muhammad0bi/Technion_044167_E.E._project_A_IOT-Barcode_cheker/Layout/PC0101122A_TOP.png

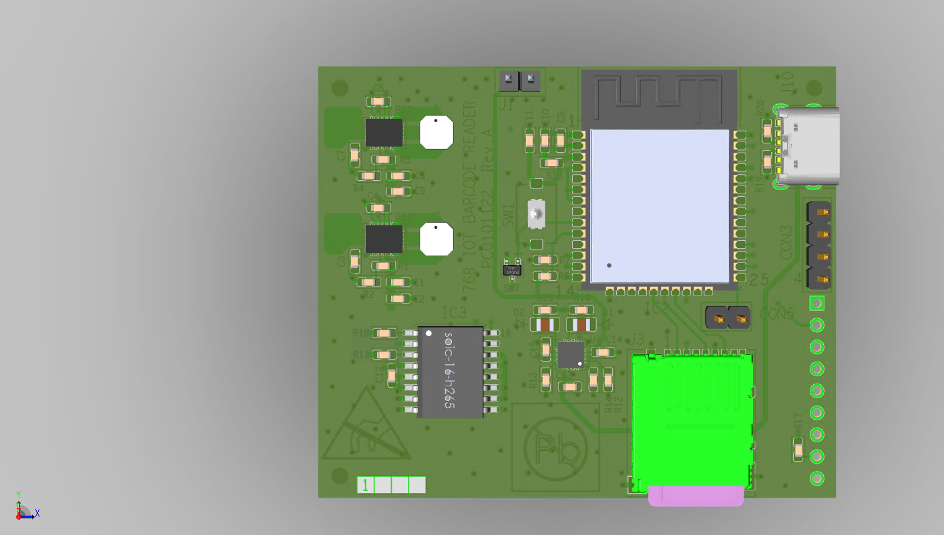
Layout/PC0101122A_TOP.png
