muhammad0bi/Technion_044167_E.E._project_A_IOT-Barcode_cheker/Poster/poster.pptx

IOT-Barcode checker
Omar Sharafi & Muhammad Biadsy
Supervised by: Mony Orbach

After all, with the project expectations, almost all the project requirement were achieved:
- Create a user-friendly device that Compare between barcodes and give us a clear result.
- Provide a log with all the scanning result via Wi-Fi with a real-time stamp.
- Mobile, compact and Re-chargeable.
- Easy to understand code.

The Andrew & Erna Viterbi Faculty of
Electrical Engineering

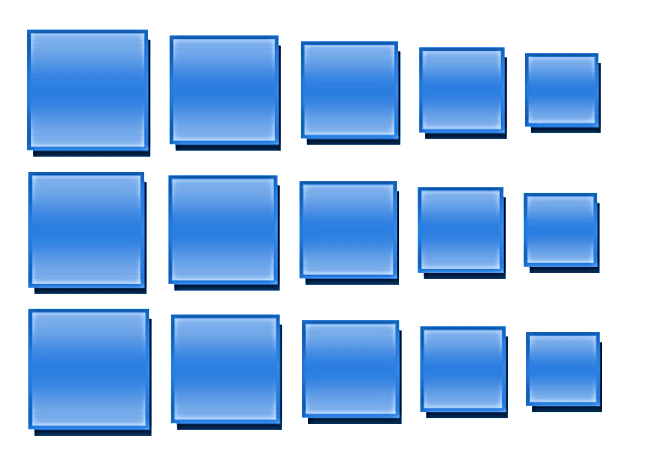
[picture p3: figure]

Electronics
Computers
Communications

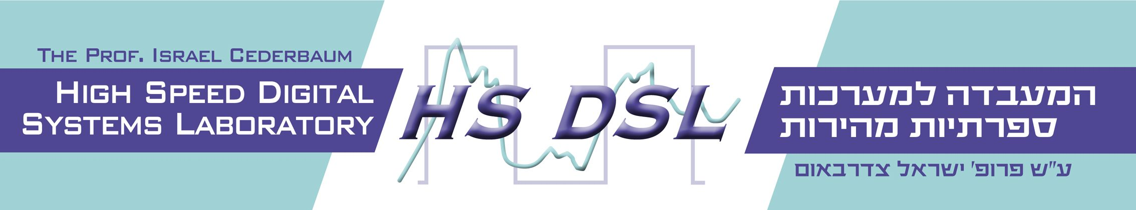
[picture p4: figure]
Technion
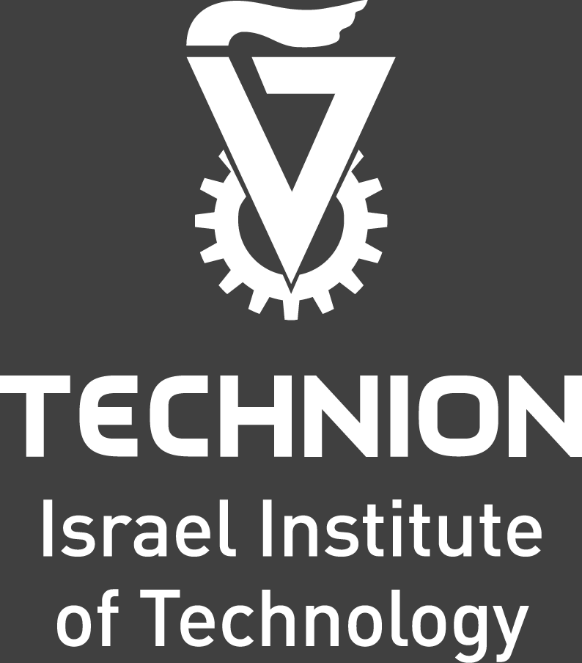
[picture p5: figure]

Project goals

- This project, in collaboration with Bnai Zion Medical Center, addresses the mismanagement of patient samples in hospital laboratories.
- Patient samples are barcoded, but manual handling of multiple samples can cause mix-ups. Reliable verification is needed to ensure accuracy at every stage.
- To avoid this problem, we want to develop A Compact And Portable Device that :
  - Compare between barcodes and give us a clear result.
  - Provide a log with all the scanning results.
  - Communicatee via Wi-Fi with a computer.
  - Mobile, compact and Re-chargeable.

Block Diagram

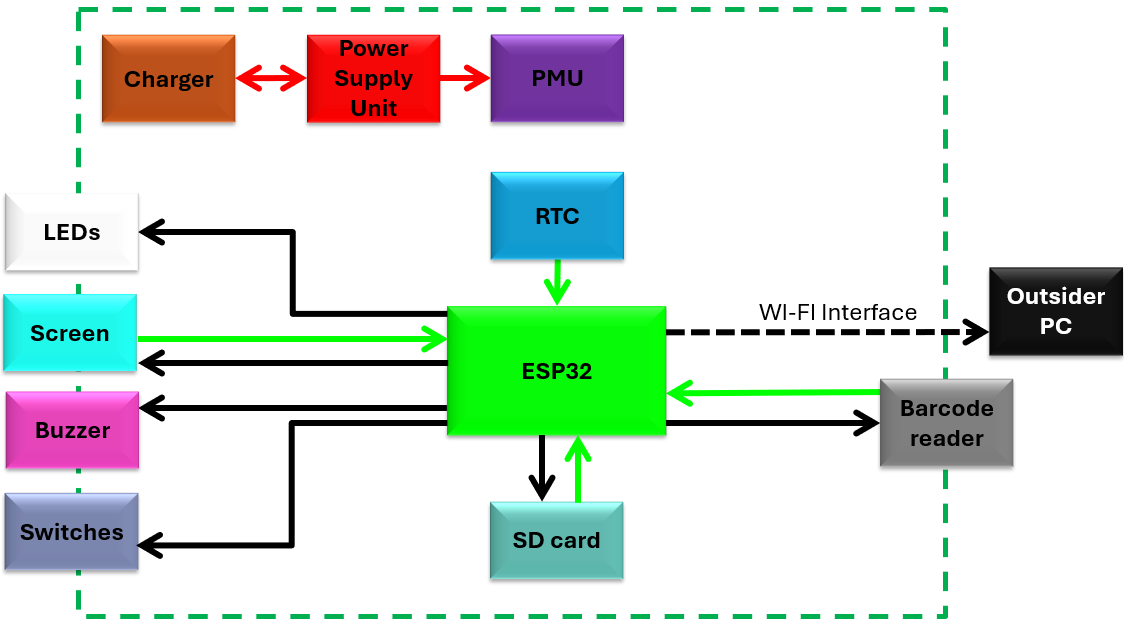
[picture p6: figure]
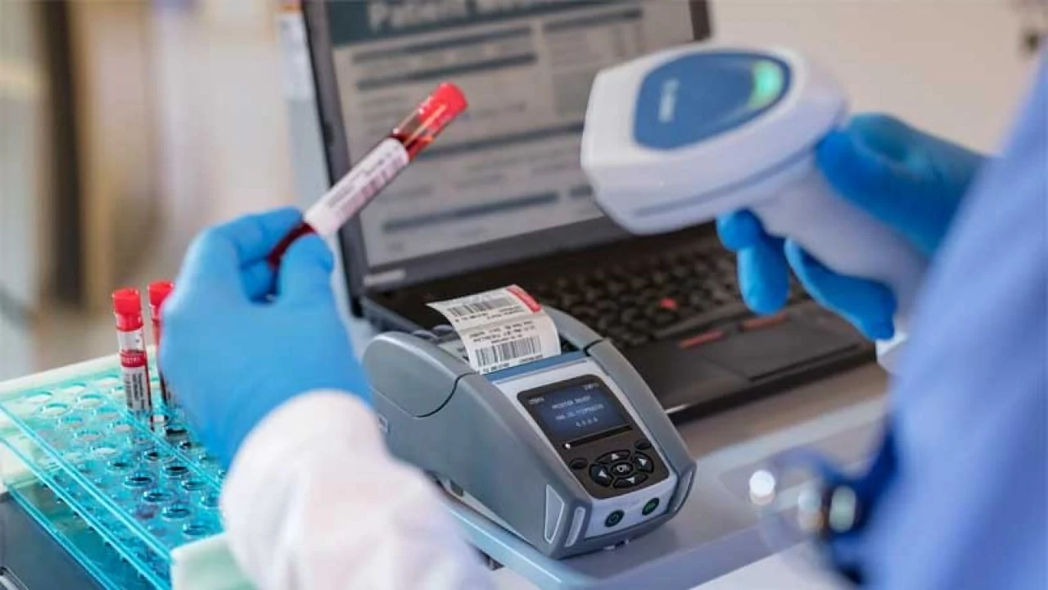
[picture p7: figure]

Flow Chart

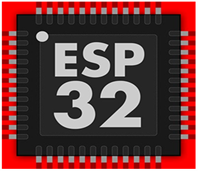
[picture p8: figure]
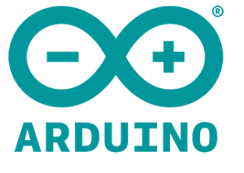
[picture p9: figure]

Device Screen & Wi-fi page

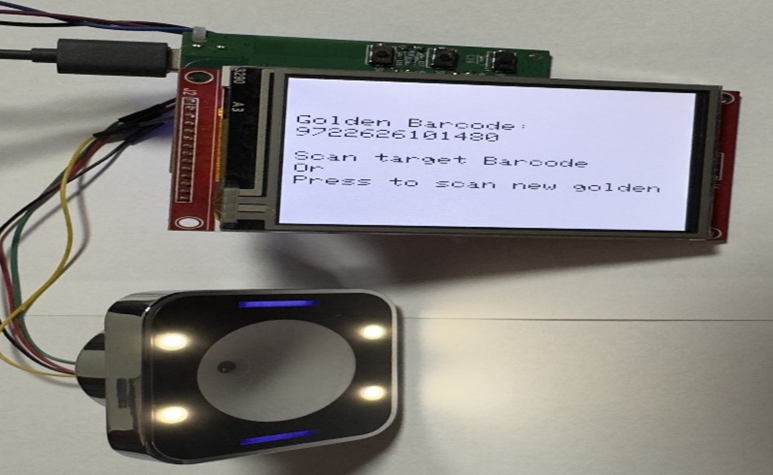
[picture p10: figure]
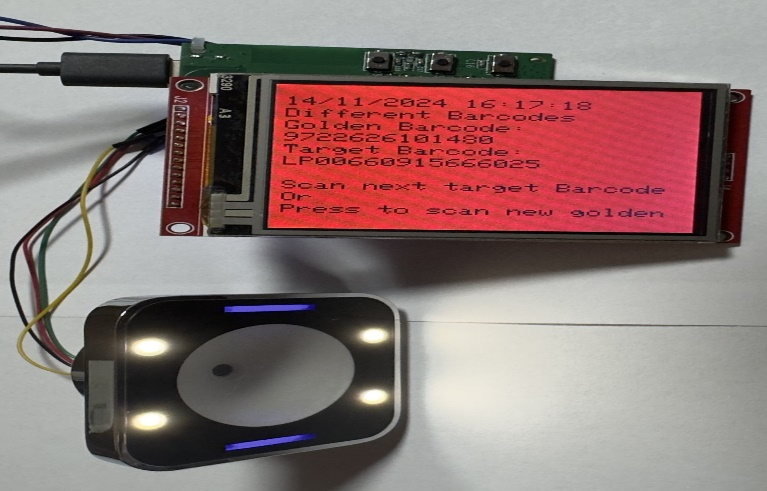
[picture p11: figure]

Communication Map

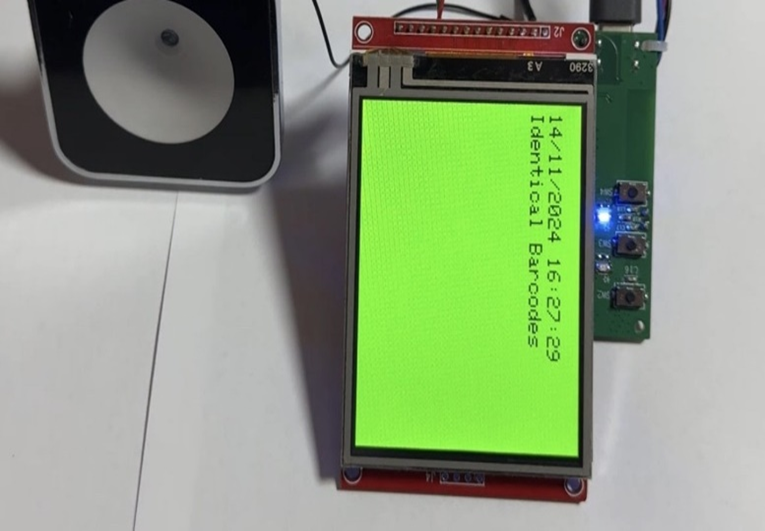
[picture p12: figure]
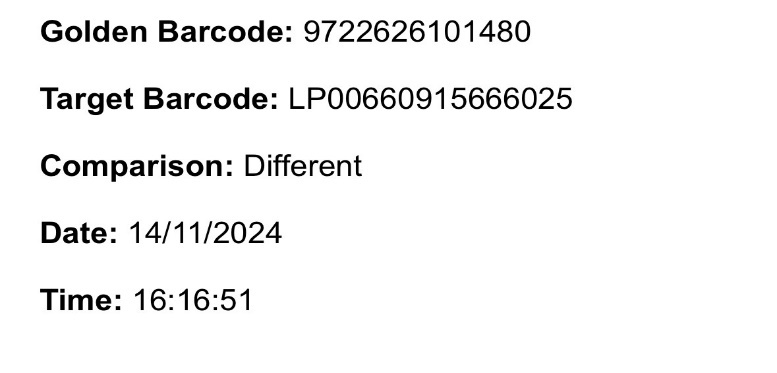
[picture p13: figure]
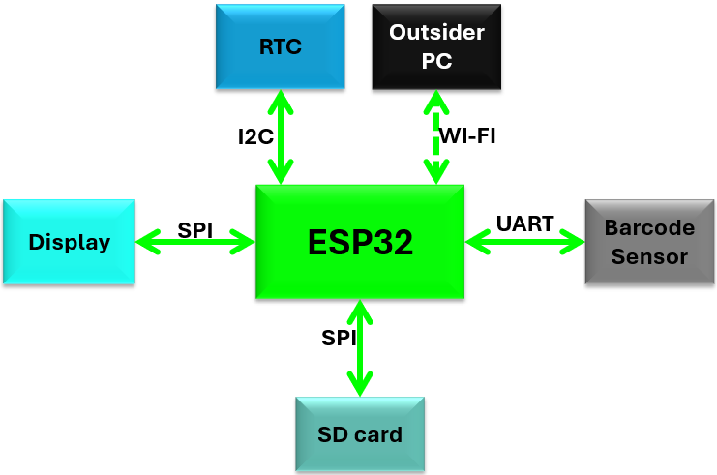
[picture p14: figure]

Results

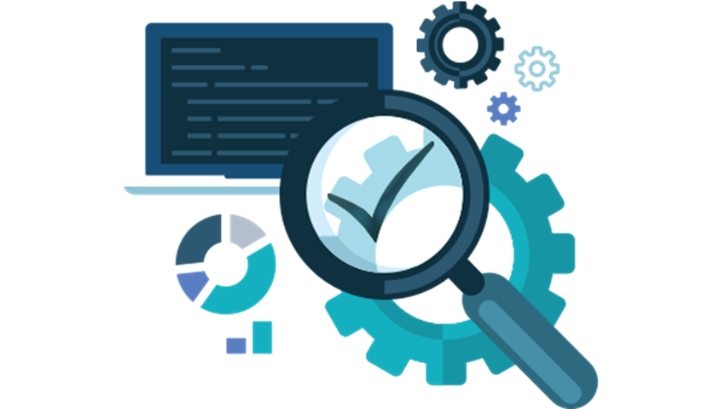
[picture p15: figure]
