muhammad0bi/Technion_044167_E.E._project_A_IOT-Barcode_cheker/Web/short descrption of the project.docx

In collaboration with Bnai Zion Medical Center, this project aims to develop a low-cost barcode checker device to prevent mismanagement of patient samples through accurate labeling with unique barcodes.
