muhammad0bi/Technion_044167_E.E._project_A_IOT-Barcode_cheker/Presntations/Midterm presentation IOT Barcode checker 7681.pptx

## MIDTERM presentation Barcode CHECKER 7681

By: Omar Sharafy, Muhammad Biadsy
Instructor: Mony Orbach
Lab: HSDSL
Spring Semester 2024

## BACKGOUND & Motivation

In Hospitals, Samples are collected from patients and labeled with unique barcode stickers.
- Visual Checking: In the lab, samples are checked visually against patient barcodes in the system.
- Potential Issues: High number of samples can cause confusion and mix-ups, resulting in issuing wrong meds and treatments.
- Difficulty in Comparison: Visual comparison of barcodes is challenging for lab personnel (Or any human for that matter).

## Goals

- Development of an easy to carry and simple tool that solves the problem of confusion in the hospital laboratory .
The tool should :
- Compare between barcodes and give us a clear result.
- Provide a log with all the scanning results.
- Mobile, compact and Re-chargeable.
- communicatee via Wi-Fi with a computer.

## Components & work development

Components :
- Barcode reader (Including built in buzzer).
- Esp32.
- Screen - SPI TFT LCD.
- Realtime clk.
- Charger – USB Type-C.
- Sd card.
- LEDs.

Work development :
Arduino developing environment.

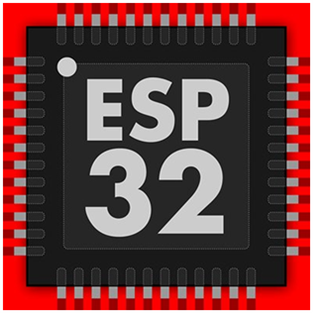
[picture p51: figure]
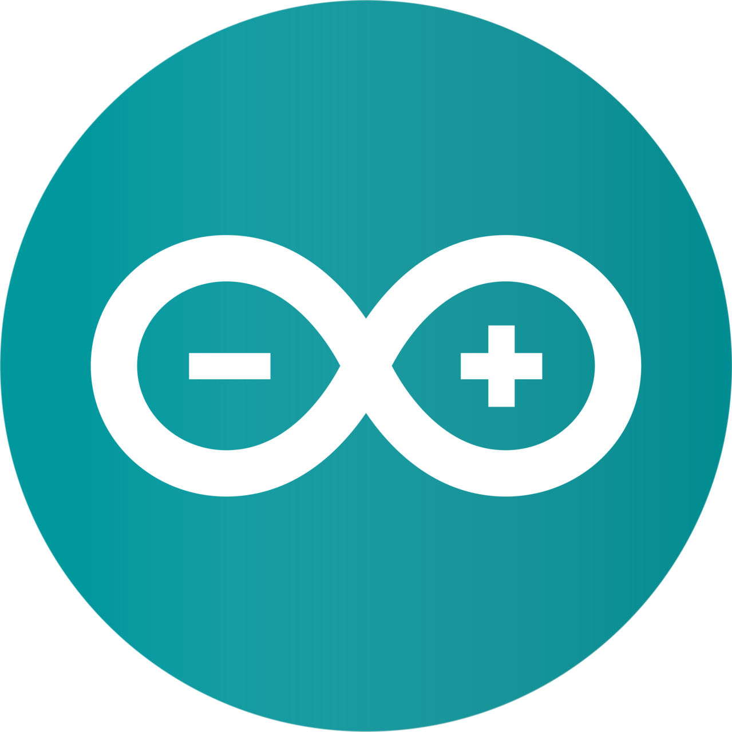
[picture p52: figure]

Notes: Barcode Dimension 2.6*5.6*5.6cm
Screen 4.2 * 3.9 inches

## TOP VIEW Block diagram

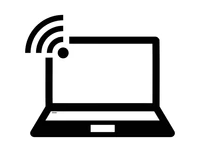
[picture p53: figure]

Outsider PC

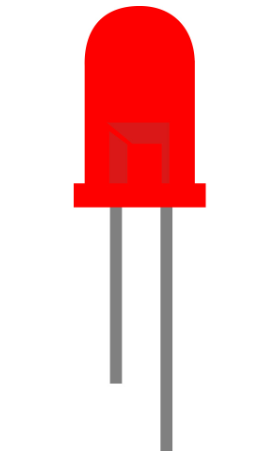
[picture p54: figure]
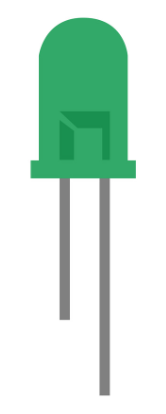
[picture p55: figure]

WI-FI
Interface

DEVICE

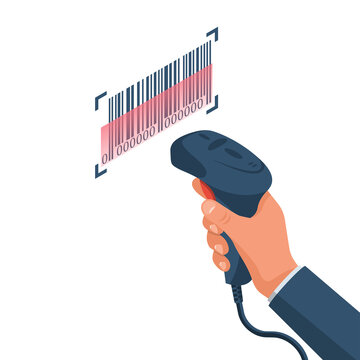
[picture p56: figure]

Target Barcode

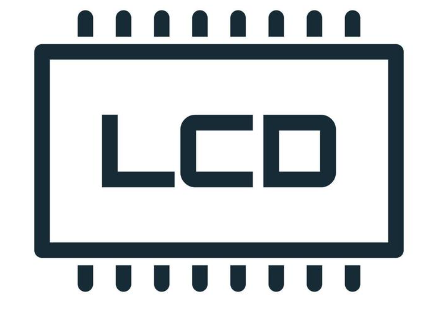
[picture p57: figure]

User

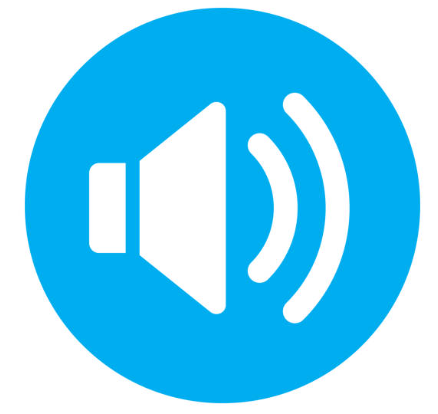
[picture p58: figure]
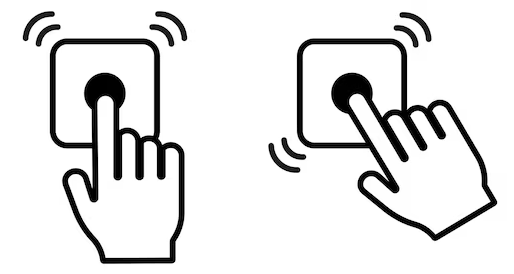
[picture p59: figure]

## Mod of work Diagram

Show the result via sound + screen & LED’s, and save the result

start

Scan the “Golden barcode”

Scan the target barcode

- After each comparison, we will log both the Golden and target barcodes, along with the results, time and date of scanning.
- When the device’s memory is full, the user can decide if he wants to override some results or delete all and start a new log.
- The log record can be accessed via WI-FI.

## Block diagram

Charger

Power Supply Unit

PMU

LEDs

RTC

ESP32

Screen

WI-FI Interface

Outsider PC

Barcode reader

Buzzer

Switches

SD card

## Power MNAGMENT UNIT

Input 5V

DC/DC Converter

DC/DC Converter

For Barcode reader

Output 5V

Output 3.3V

For ESP32 & other components

## Communication Diagram

RTC

I2C

Outsider PC

WI-FI

Display

SPI

ESP32

SPI

SD card

UART

Barcode Sensor

## ESP32

- Includes many drivers that make programming easier.
- Advantages over Arduino nano: speed and memory
- 2 cores.

| ESP32 | Arduino nano
Clock rate | 80 MHz | 16 MHz
Memory size | 520 KB SRAM 4 MB flash memory | 2 KB SRAM 32 KB flash

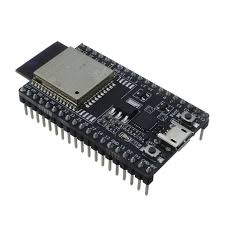
[picture p60: figure]
ESP32-DEVKITC-32D Espressif Systems | RF/IF ו- RFID | DigiKey

## Barcode reader

- 2D Barcode scanner.
- Built in buzzer that we can adapt it to our project.
- Supports Arduino development Environment.

Notes: 125 mA = I
Built in buzzer
Built in led

## Display

- 3.2 inch.
- 240X320 pixels.
- Supports Arduino development Environment.
- Can be powered with 3.3V.

## Arduino developing environment

- Supports the ESP32.
- Rich collection of libraries for various sensors and communication protocols.
- Easy to use and quickly start coding.
- Supports wide range of applications.

## Until now

- Define objectives.
- E.E Scheme.
- PCB design – in production process.
- Case design in process.

## Layout - TOP

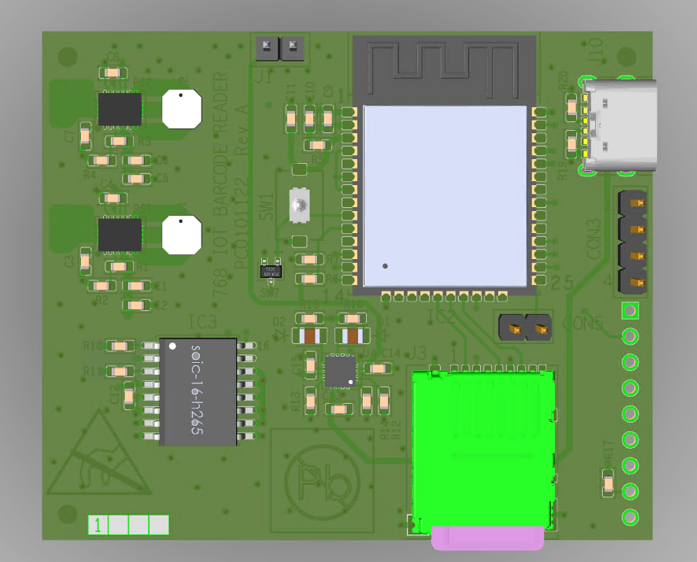
[picture p61: figure]
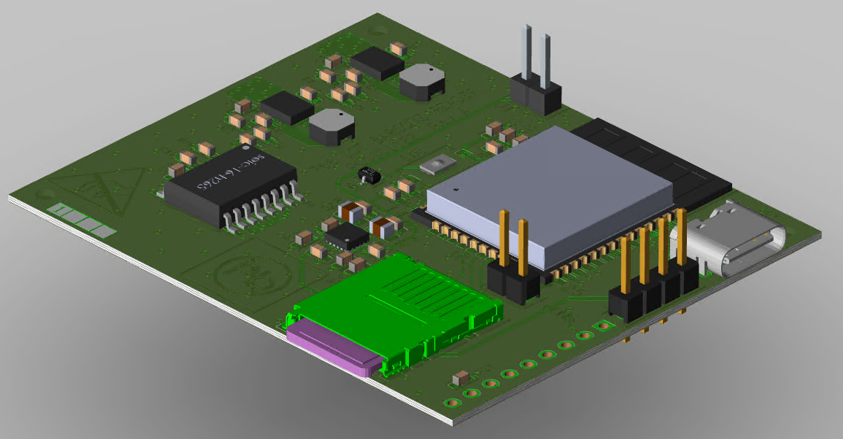
[picture p62: figure]

## Layout - BOTTOM

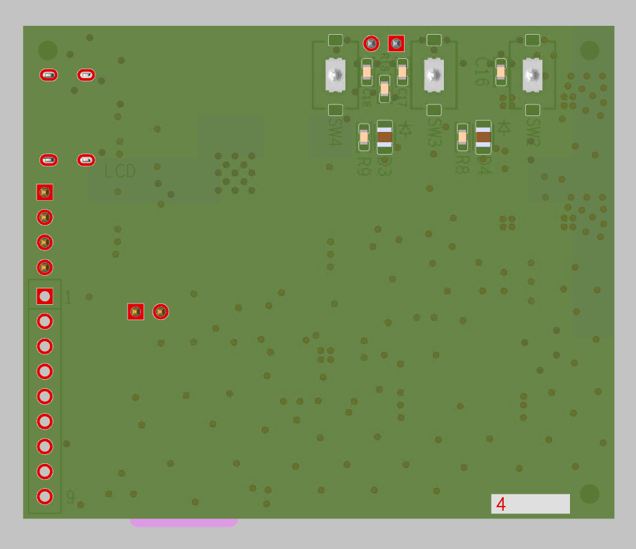
[picture p63: figure]
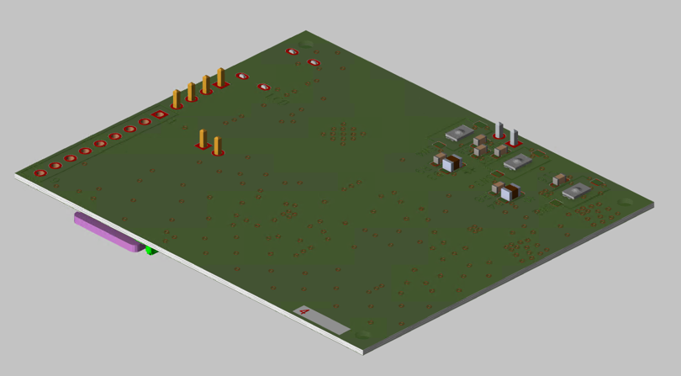
[picture p64: figure]

## Gant diagram

| 18Aug24 | 25Aug24 | 1Sep24 | 22Sep24 | 29Sep24 | 5Oct24 | 19Oct24 |10Nov24

layout

Today

Exams

Designing a case via 3D Printer

Software development

Debug

Hardware bring-up

Integration

Final presentation
