muhammad0bi/Technion_044167_E.E._project_A_IOT-Barcode_cheker/Layout/PCB_Layout.pptx

HOME Unit

barcode con

Dc2d 3v

Dc2d 5v

Esp32

Screen con
9 pins not 4

RTC

Switch

Switch

Switch

+

2cm

Battary con

LED

LED

USB

## Slide 2

FIELD Unit

Sd card
