muhammad0bi/Technion_044167_E.E._project_A_IOT-Barcode_cheker/Project_Arduino_code/Readme.txt

This file contains the software aspect of our project.

1) The Project_Arduino_code file includes the final code that was uploaded to the ESP32.
2) The Bring_up_components folder contains a collection of files,
each representing a small test program used to verify and initialize individual components of our project.
Each file is named after the specific component it was designed to test and bring up.
