muhammad0bi/Technion_044167_E.E._project_A_IOT-Barcode_cheker/Electrical Schematic/Original_re-wired/DC_TO_DC_3V.pdf

## Notes:

1. The value of the inductor is from TPS63020DSJT,

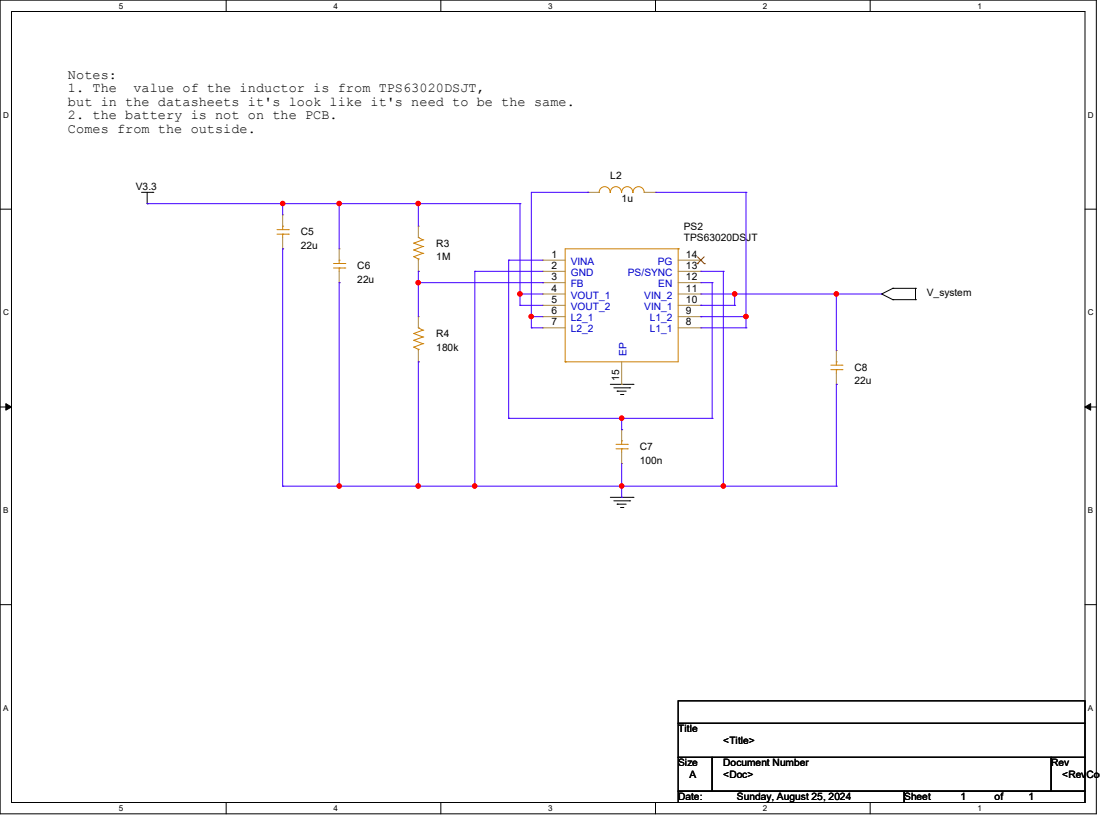
[picture p70: page 1]
V_system; Title; Size; Document Number; Rev; Date:; Sheet; <Doc>; <RevCode>; <Title>; Sunday, August 25, 2024; PS2 TPS63020DSJT; VINA 1 GND 2 FB 3 VOUT_1 4 VOUT_2 5 L2_1 6; PS/SYNC; VIN_2; VIN_1

but in the datasheets it's look like it's need to be the same.
2. the battery is not on the PCB.
Comes from the outside.
