muhammad0bi/Technion_044167_E.E._project_A_IOT-Barcode_cheker/Electrical Schematic/Original_re-wired/DC_TO_DC_BOOST_5V.pdf

## Notes:

1. The value of the inductor is from TPS63020DSJT,

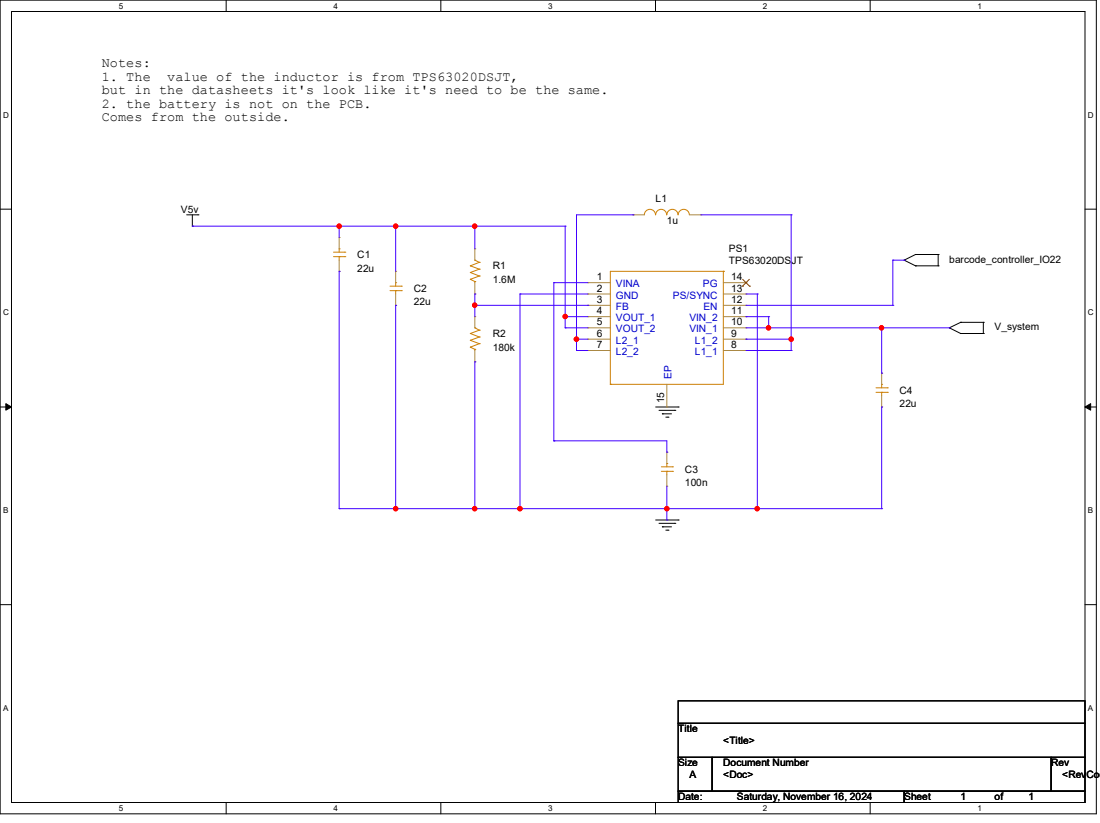
[picture p71: page 1]
barcode_controller_IO22; V_system; Title; Size; Document Number; Rev; Date:; Sheet; <Doc>; <RevCode>; <Title>; Saturday, November 16, 2024; PS1 TPS63020DSJT; VINA 1 GND 2 FB 3 VOUT_1 4 VOUT_2 5 L2_1 6; PS/SYNC; VIN_2; VIN_1

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
