muhammad0bi/Technion_044167_E.E._project_A_IOT-Barcode_cheker/Electrical Schematic/Original_re-wired/PMU.pdf

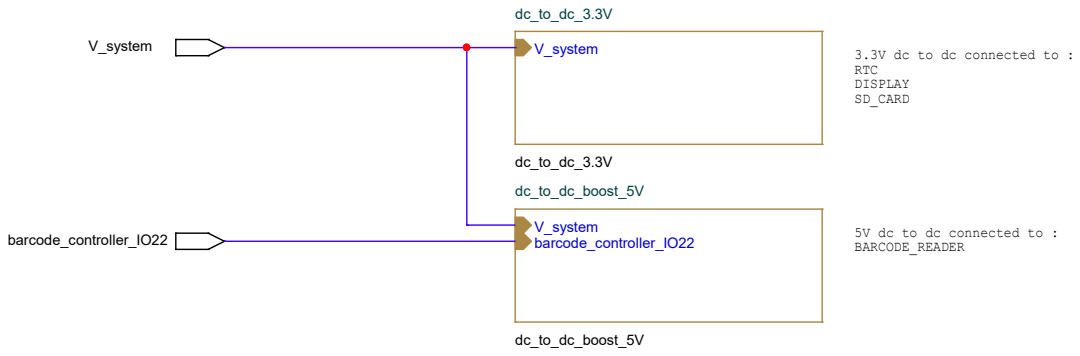
[picture p73: page 1]
BARCODE_READER barcode_controller_IO22; V_system; Title; Size; Document Number; Rev; Date:; Sheet; <Doc>; <RevCode>; <Title>; Saturday, November 16, 2024; dc_to_dc_boost_5V; barcode_controller_IO22

3.3V dc to dc connected to :
RTC
DISPLAY
SD_CARD

5V dc to dc connected to :
