muhammad0bi/Technion_044167_E.E._project_A_IOT-Barcode_cheker/Electrical Schematic/Original_re-wired/RTC.pdf

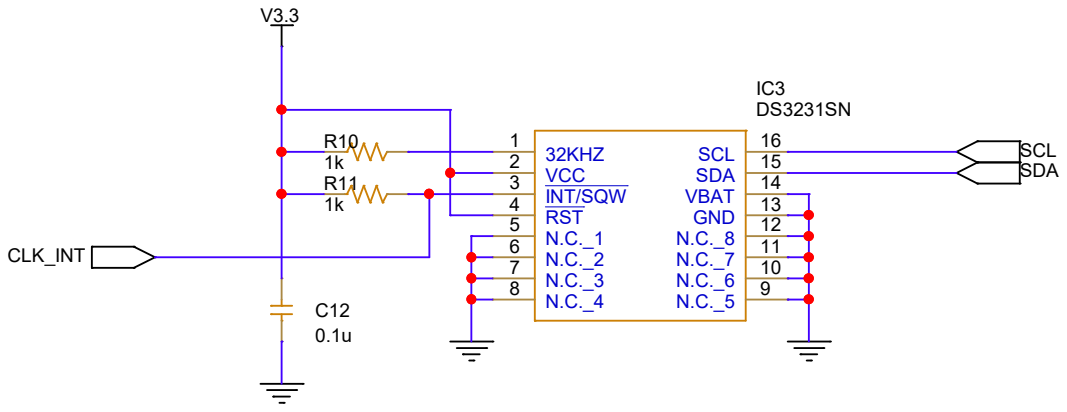
[picture p74: page 1]
SCL SDA; CLK_INT; Title; Size; Document Number; Rev; Date:; Sheet; <Doc>; <RevCode>; <Title>; Sunday, August 25, 2024; 32KHZ 1 VCC 2 INT/SQW 3 RST 4 N.C._1 5 N.C._2 6 N.C._3 7 N.C._4 8; SCL; SDA; VBAT; GND
