muhammad0bi/Technion_044167_E.E._project_A_IOT-Barcode_cheker/Electrical Schematic/Original_re-wired/SD_SLOT.pdf

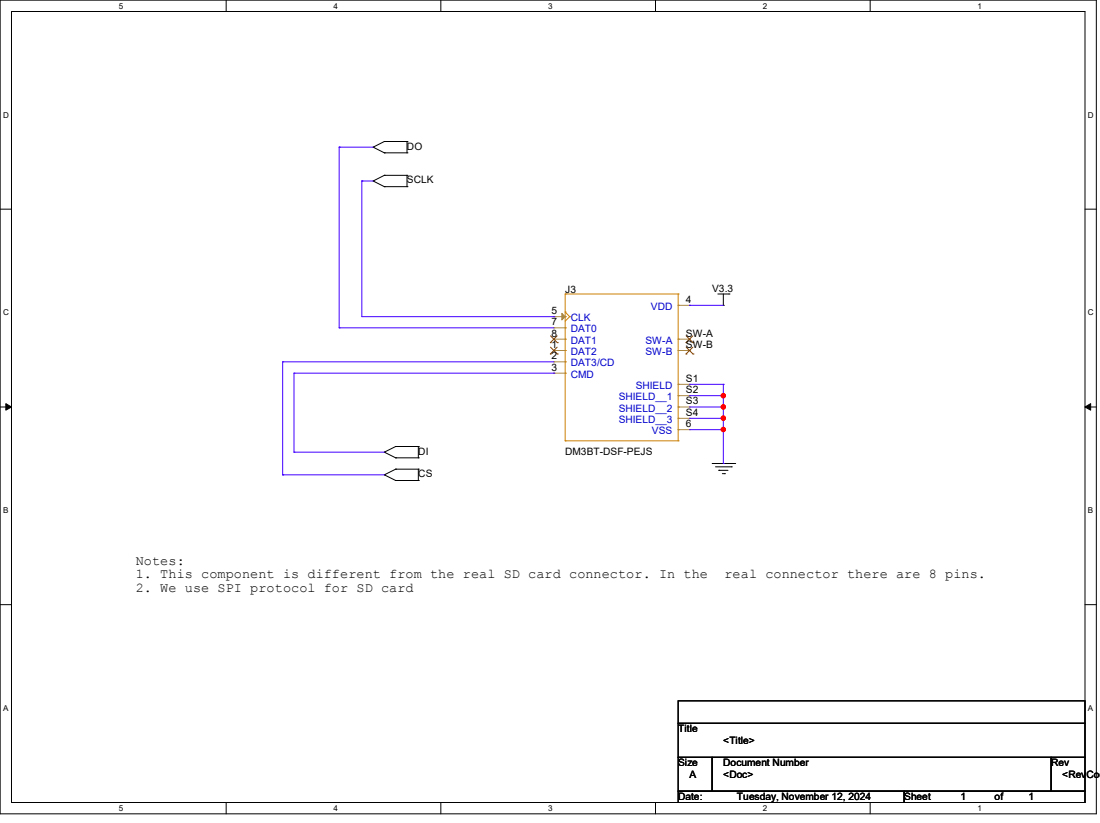
[picture p75: page 1]
SCLK; Title; Size; Document Number; Rev; Date:; Sheet; <Doc>; <RevCode>; <Title>; Tuesday, November 12, 2024; DM3BT-DSF-PEJS; SHIELD; SHIELD__2; S3 SHIELD__1; SHIELD__3; DAT2 1 DAT3/CD 2 CMD 3; VDD; CLK 5; VSS; DAT0 7; DAT1 8

Notes:
1. This component is different from the real SD card connector. In the real connector there are 8 pins.
2. We use SPI protocol for SD card
