muhammad0bi/Technion_044167_E.E._project_A_IOT-Barcode_cheker/Electrical Schematic/Original_re-wired/SWITCHS.pdf

## Notes: 1. the inputs going out and connecting to

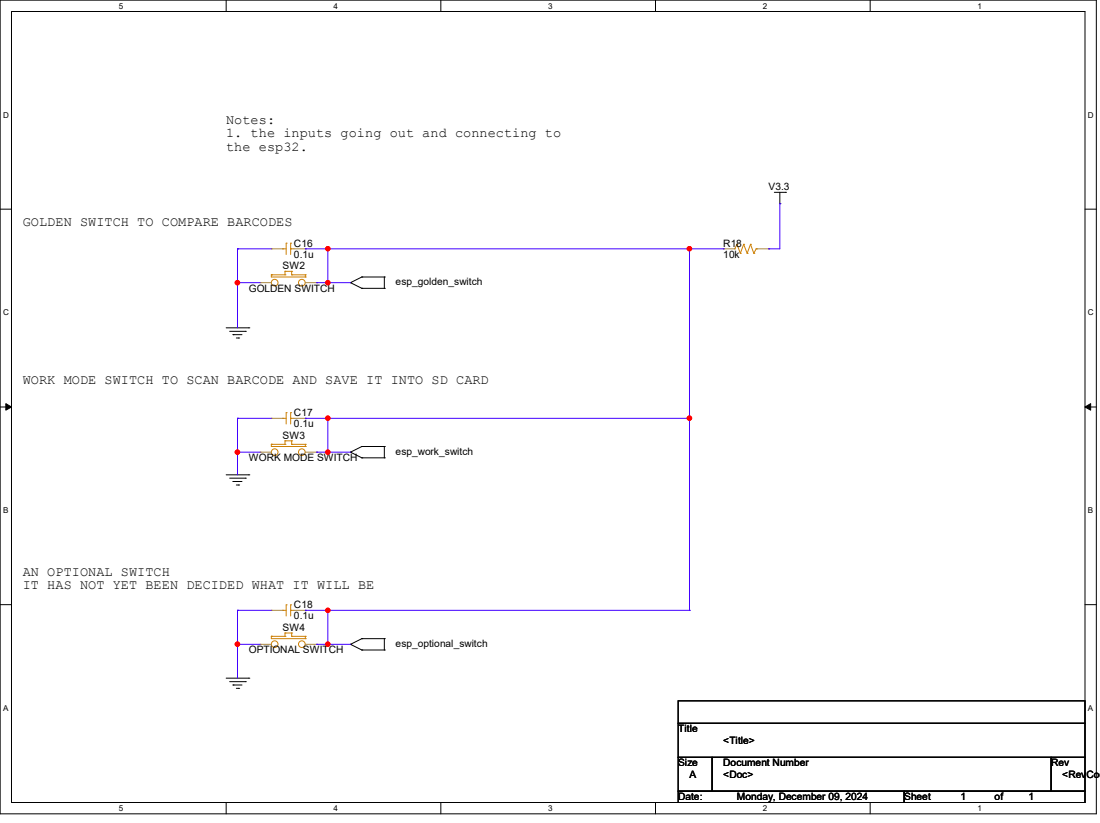
[picture p76: page 1]
the esp32.; esp_golden_switch; esp_work_switch; esp_optional_switch; Title; Size; Document Number; Rev; Date:; Sheet; <Doc>; <RevCode>; <Title>; Monday, December 09, 2024; GOLDEN SWITCH; OPTIONAL SWITCH

GOLDEN SWITCH TO COMPARE BARCODES

WORK MODE SWITCH TO SCAN BARCODE AND SAVE IT INTO SD CARD

WORK MODE SWITCH

AN OPTIONAL SWITCH
IT HAS NOT YET BEEN DECIDED WHAT IT WILL BE
