muhammad0bi/Technion_044167_E.E._project_A_IOT-Barcode_cheker/Electrical Schematic/Original_re-wired/Top.pdf

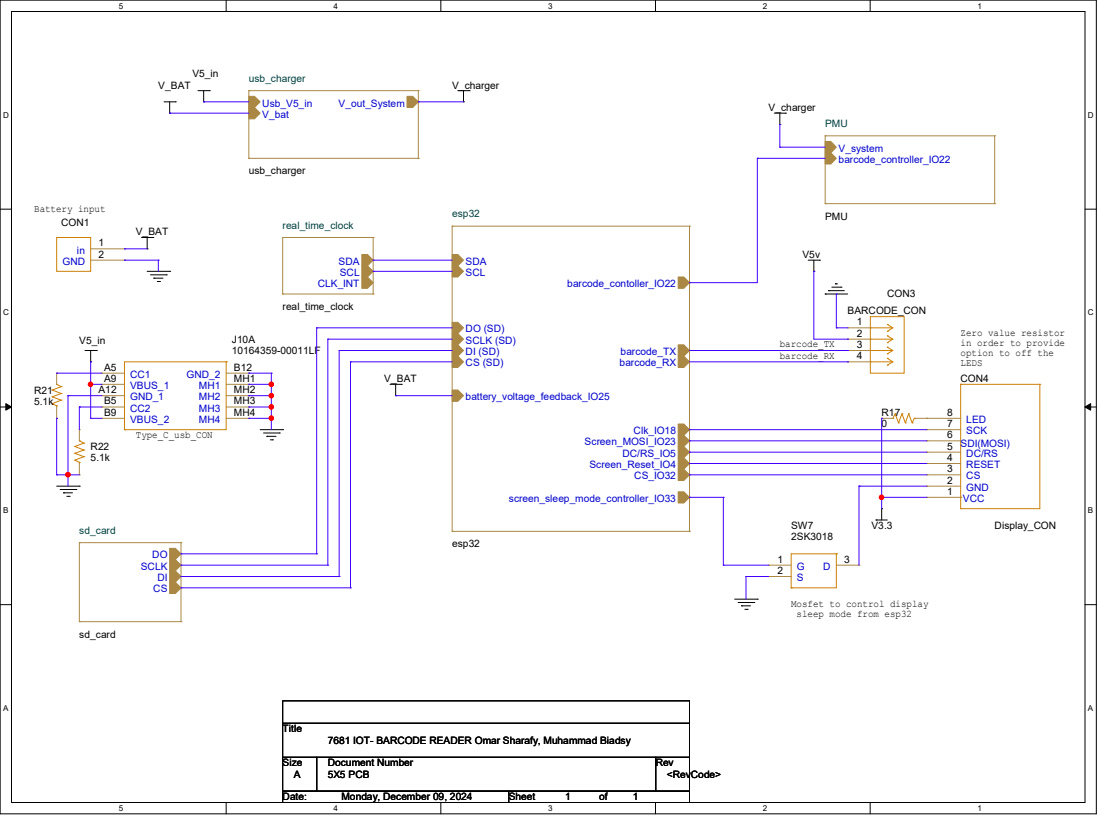
[picture p77: page 1]
barcode_RX; barcode_TX; Battery input; Type_C_usb_CON; V_BAT; V_charger; Title; Size; Document Number; Rev; Date:; Sheet; 5X5 PCB; <RevCode>; Monday, December 09, 2024; esp32; battery_voltage_feedback_IO25; SCLK (SD) DI (SD); screen_sleep_mode_controller_IO33; barcode_contoller_IO22; barcode_TX barcode_RX; Screen_Reset_IO4; Screen_MOSI_IO23; Clk_IO18; SDA SCL; PMU; barcode_controller_IO22; V_system; usb_charger; Usb_V5_in; V_out_System; V_bat; real_time_clock; SCL; SDA; CLK_INT; sd_card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

Zero value resistor
in order to provide
option to off the
LEDS
CON4

VBUS_2 B9

Mosfet to control display
sleep mode from esp32

7681 IOT- BARCODE READER Omar Sharafy, Muhammad Biadsy
