muhammad0bi/Technion_044167_E.E._project_A_IOT-Barcode_cheker/Electrical Schematic/Original_re-wired/USB_TYPE_C_CHARGER.pdf

## CHARGER THAT STOPS CHARGING AUTOMATICALLY WHEN THE BATRY IS FULL

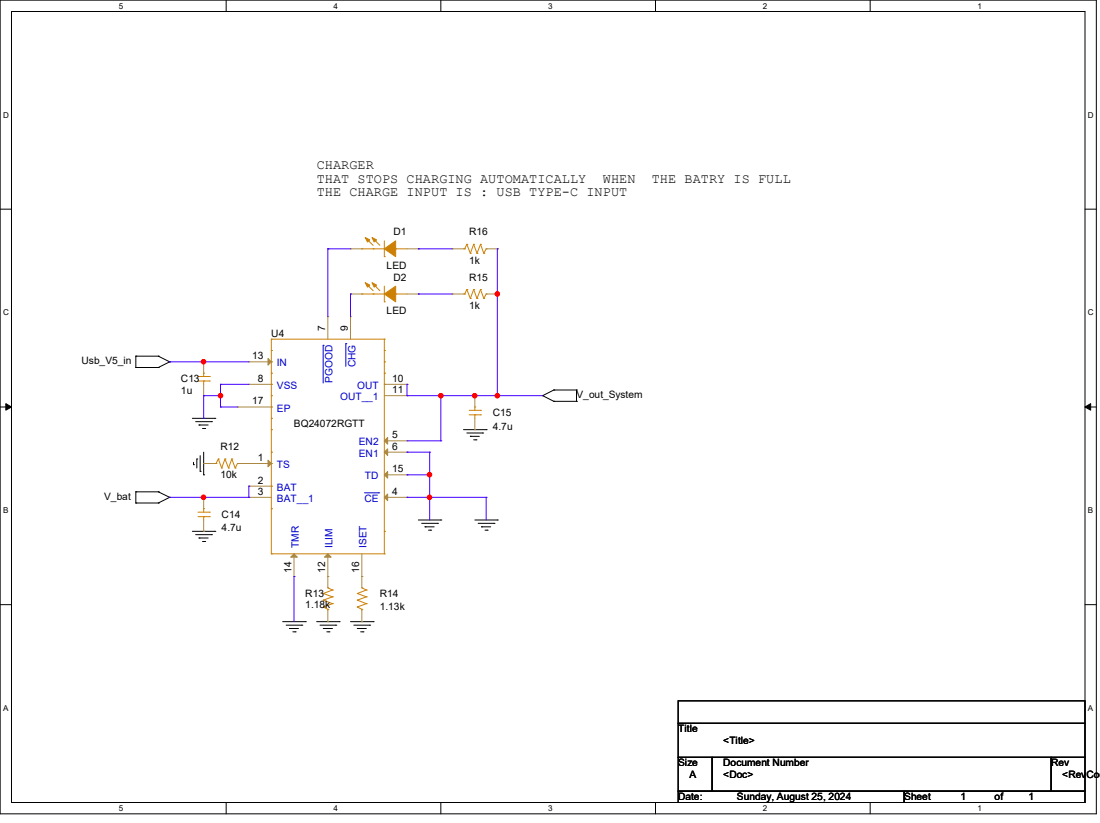
[picture p78: page 1]

THE CHARGE INPUT IS : USB TYPE-C INPUT
