muhammad0bi/Technion_044167_E.E._project_A_IOT-Barcode_cheker/Layout/PC0101122A__PC0101122A_BOARD.pdf

# Technion - Department of Electrical Engineering C3 C7 1

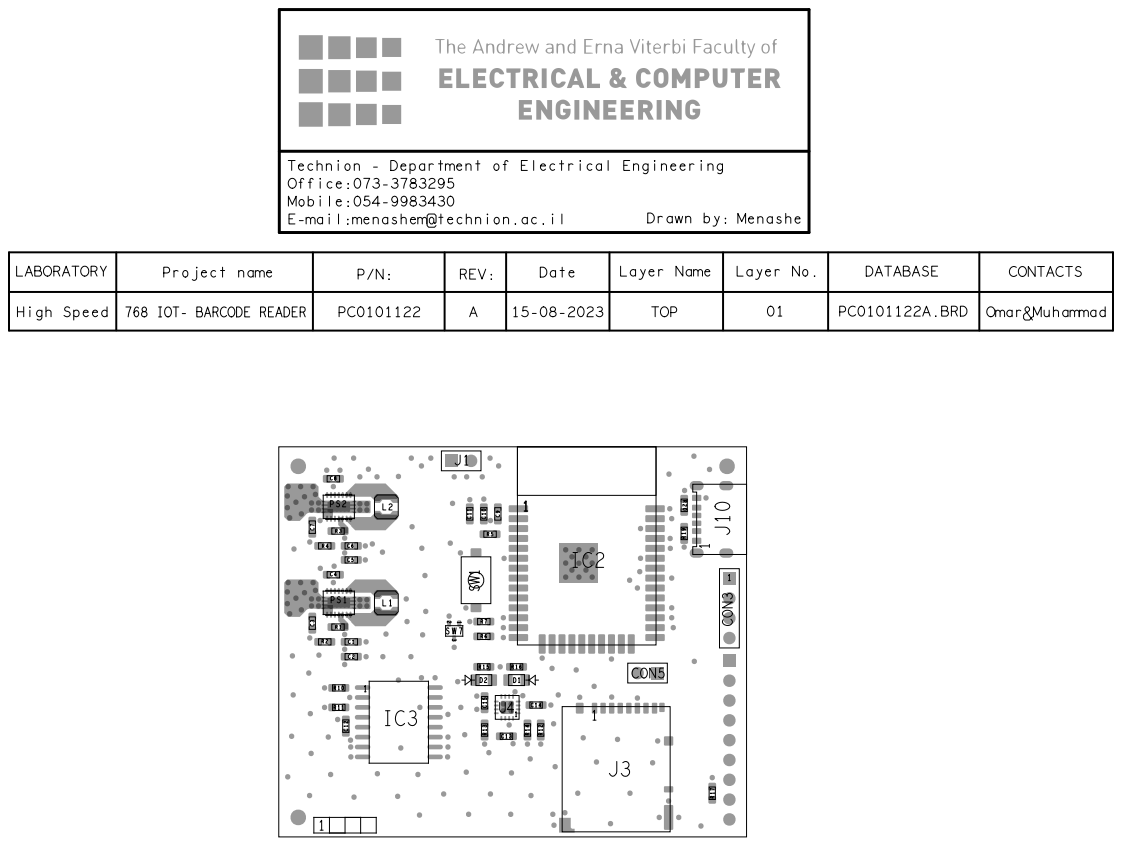
[picture p79: page 1]

Office:073-3783295
Mobile:054-9983430
E-mail:menashem@technion.ac.il

LABORATORY | Project name | Date | Layer Name | Layer No. | DATABASE | CONTACTS

High Speed | 768 IOT- BARCODE READER | 15-08-2023 | TOP | 01 | PC0101122A.BRD | Omar&Muhammad

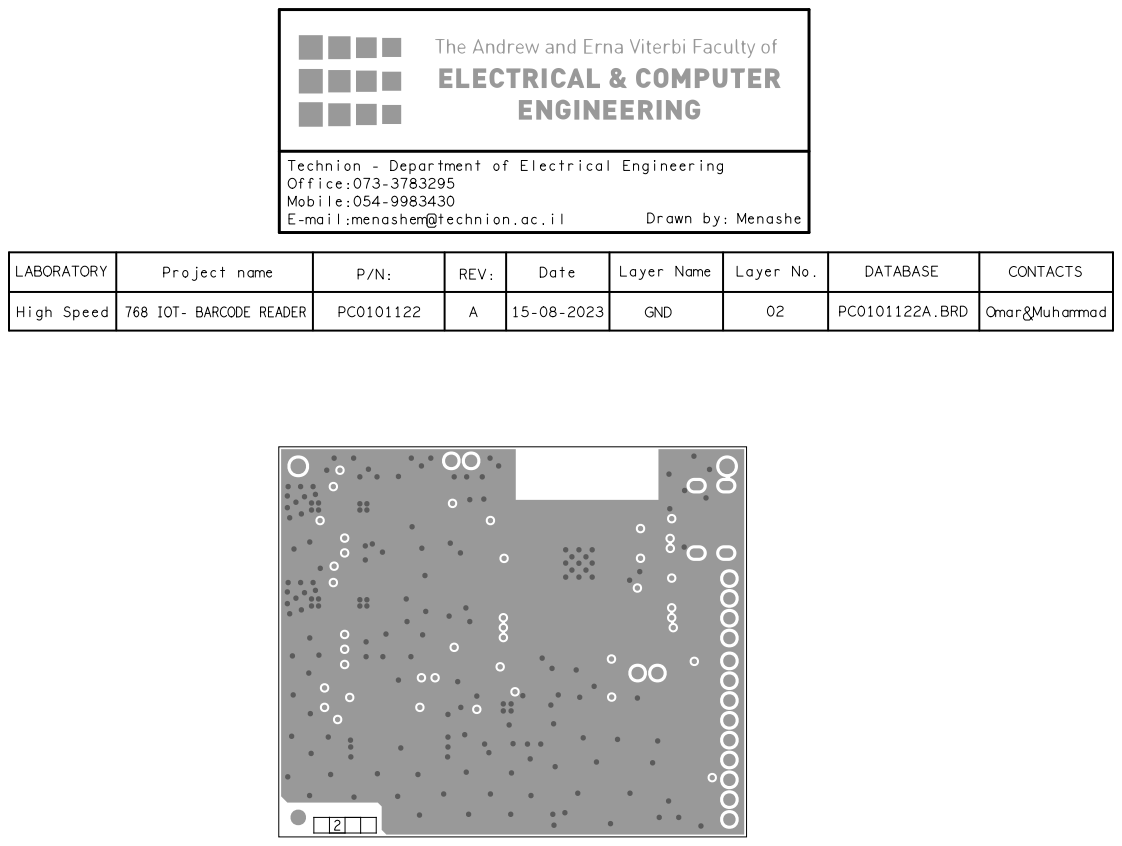
[picture p80: page 2]
Drawn by:; Menashe

Technion - Department of Electrical Engineering
Office:073-3783295
Mobile:054-9983430
E-mail:menashem@technion.ac.il

LABORATORY | Project name | P/N: | REV: | Date | Layer Name | Layer No. | DATABASE | CONTACTS

High Speed | 768 IOT- BARCODE READER | PC0101122 | A | 15-08-2023 | GND | 02 | PC0101122A.BRD | Omar&Muhammad

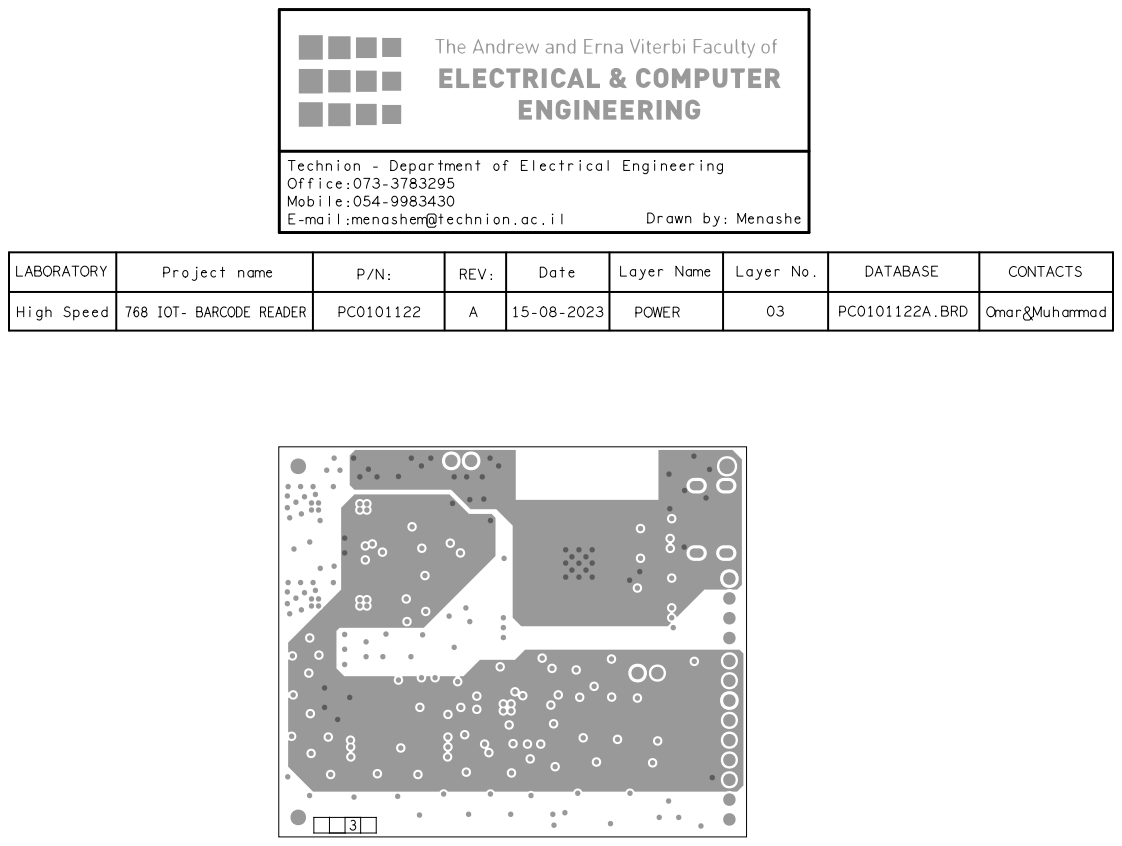
[picture p81: page 3]
Drawn by:; Menashe

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

LABORATORY | Project name | P/N: | REV: | Date | Layer Name | Layer No. | DATABASE | CONTACTS

High Speed | 768 IOT- BARCODE READER | PC0101122 | A | 15-08-2023 | POWER | 03 | PC0101122A.BRD | Omar&Muhammad

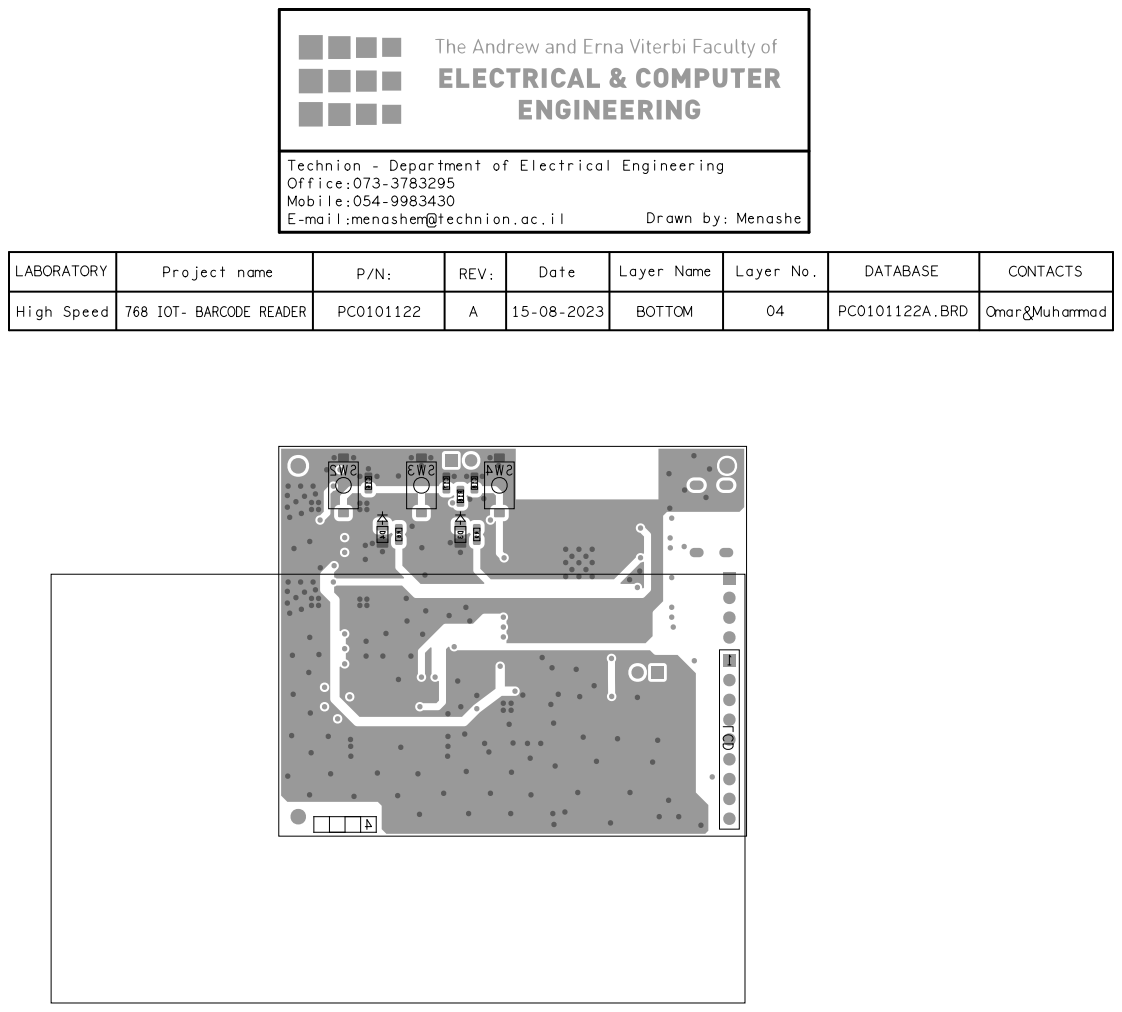
[picture p82: page 4]
D3 R18 REV:; Drawn by:; LCD; Menashe

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

LABORATORY | Project name | P/N: | Date | Layer Name | Layer No. | DATABASE | CONTACTS

High Speed | 768 IOT- BARCODE READER | PC0101122 | 15-08-2023 | BOTTOM | 04 | PC0101122A.BRD | Omar&Muhammad

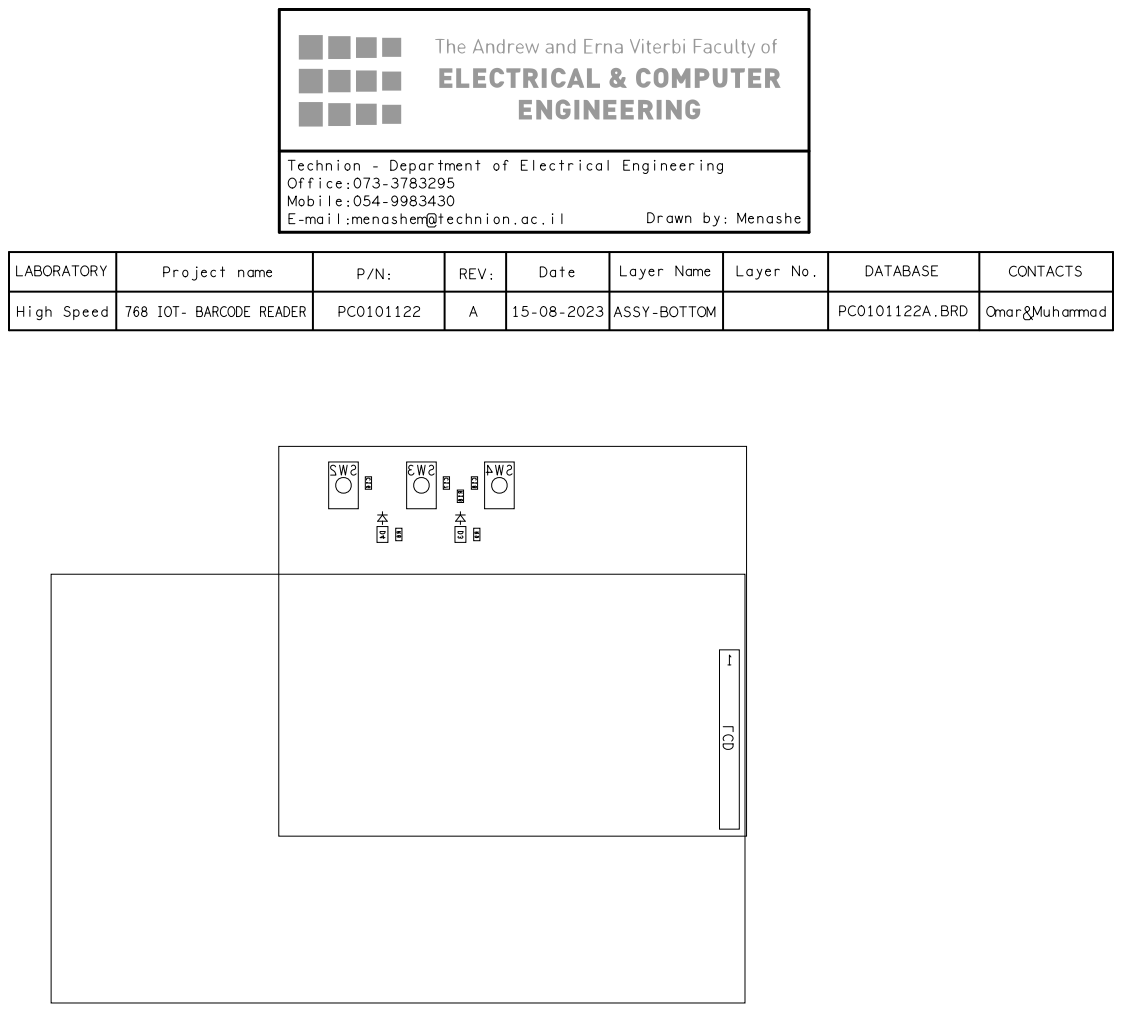
[picture p83: page 5]
D3 R18 REV:; Drawn by:; LCD; Menashe

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

LABORATORY | Project name | | Date | Layer Name | Layer No. | DATABASE | CONTACTS

High Speed | 768 IOT- BARCODE READER | PC0101122 | 15-08-2023 | ASSY-BOTTOM | | PC0101122A.BRD | Omar&Muhammad

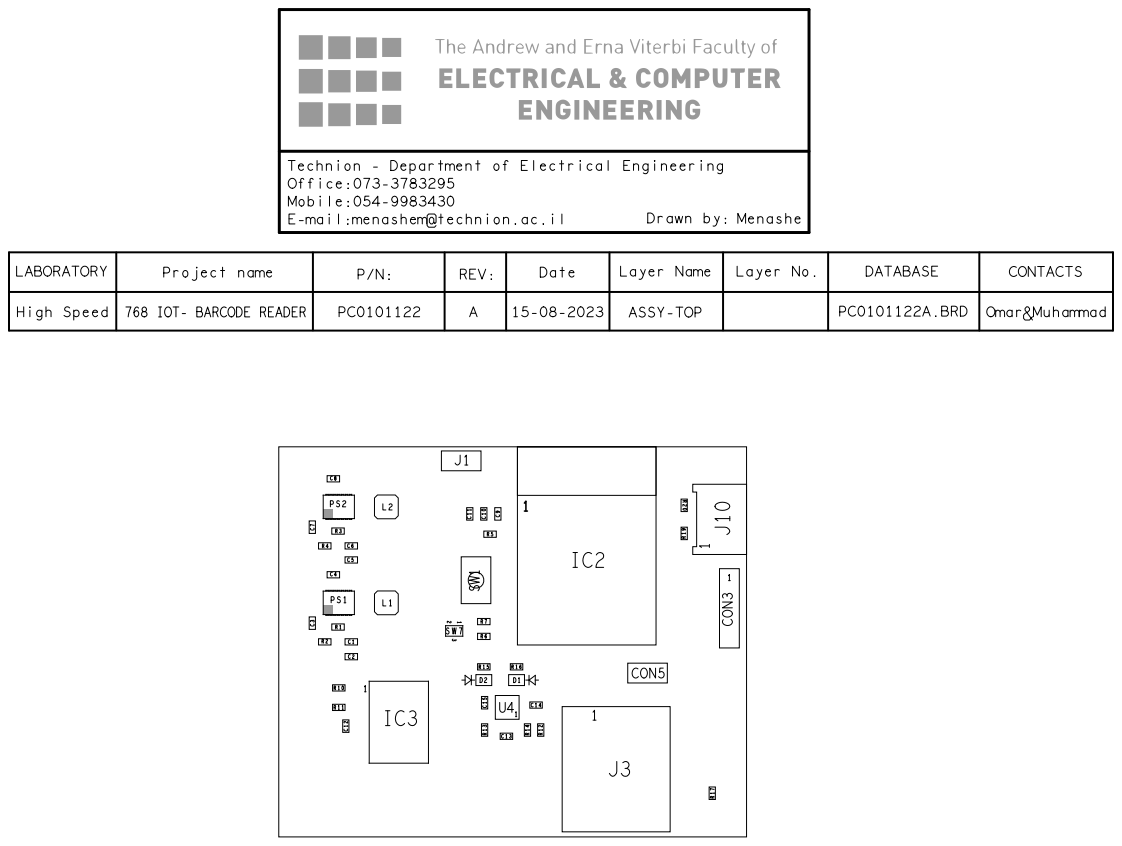
[picture p84: page 6]

Technion - Department of Electrical Engineering C3 C7
Office:073-3783295
Mobile:054-9983430
E-mail:menashem@technion.ac.il

LABORATORY | Project name | Date | Layer Name | Layer No. | DATABASE | CONTACTS

High Speed | 768 IOT- BARCODE READER | 15-08-2023 | ASSY-TOP | | PC0101122A.BRD | Omar&Muhammad

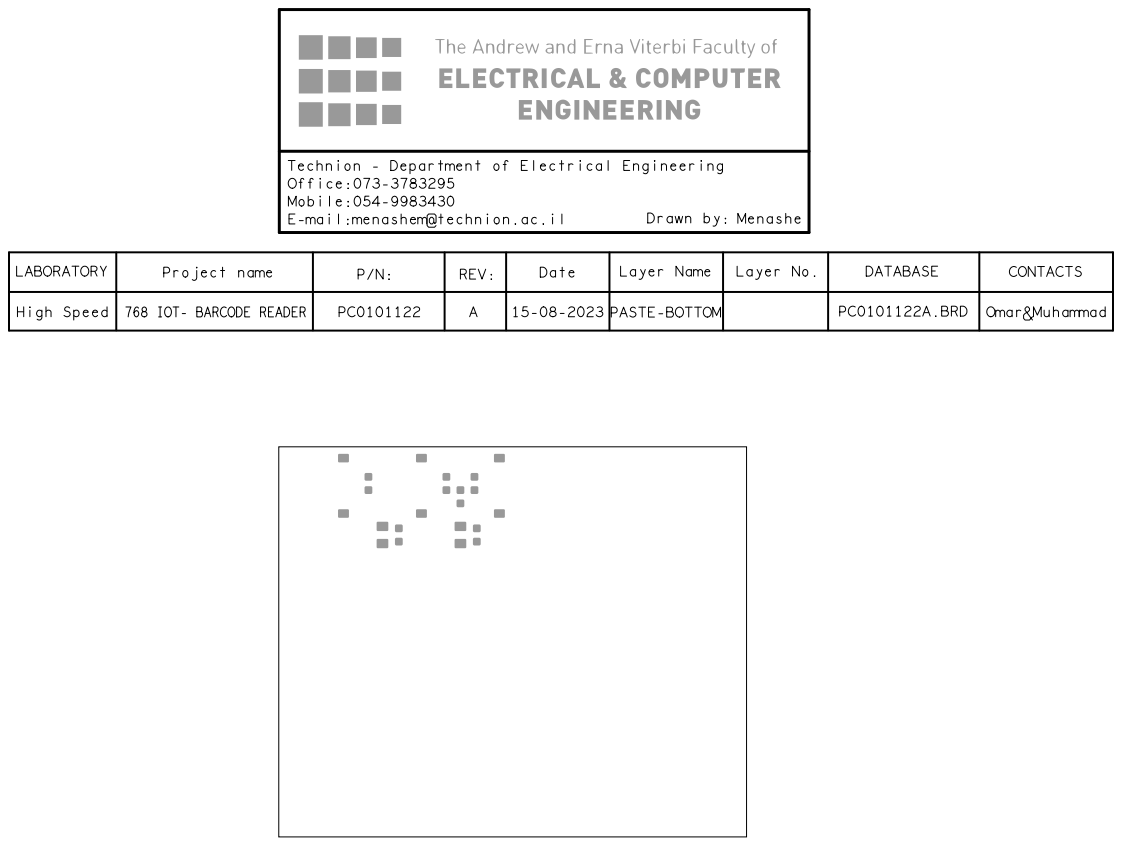
[picture p85: page 7]
Drawn by:; Menashe

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

LABORATORY | Project name | P/N: | REV: | Date | Layer Name | Layer No. | DATABASE | CONTACTS

High Speed | 768 IOT- BARCODE READER | PC0101122 | A | 15-08-2023 | PASTE-BOTTOM | | PC0101122A.BRD | Omar&Muhammad

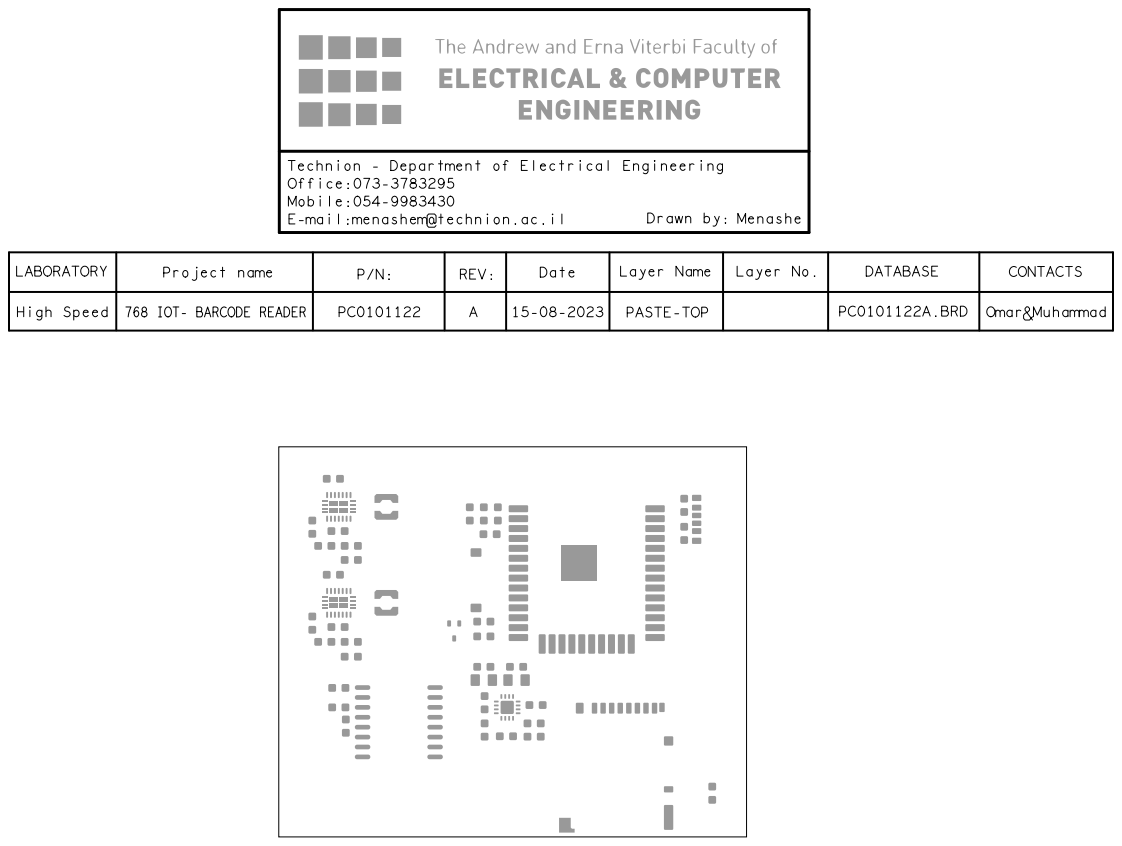
[picture p86: page 8]
Drawn by:; Menashe

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

LABORATORY | Project name | P/N: | REV: | Date | Layer Name | Layer No. | DATABASE | CONTACTS

High Speed | 768 IOT- BARCODE READER | PC0101122 | A | 15-08-2023 | PASTE-TOP | | PC0101122A.BRD | Omar&Muhammad

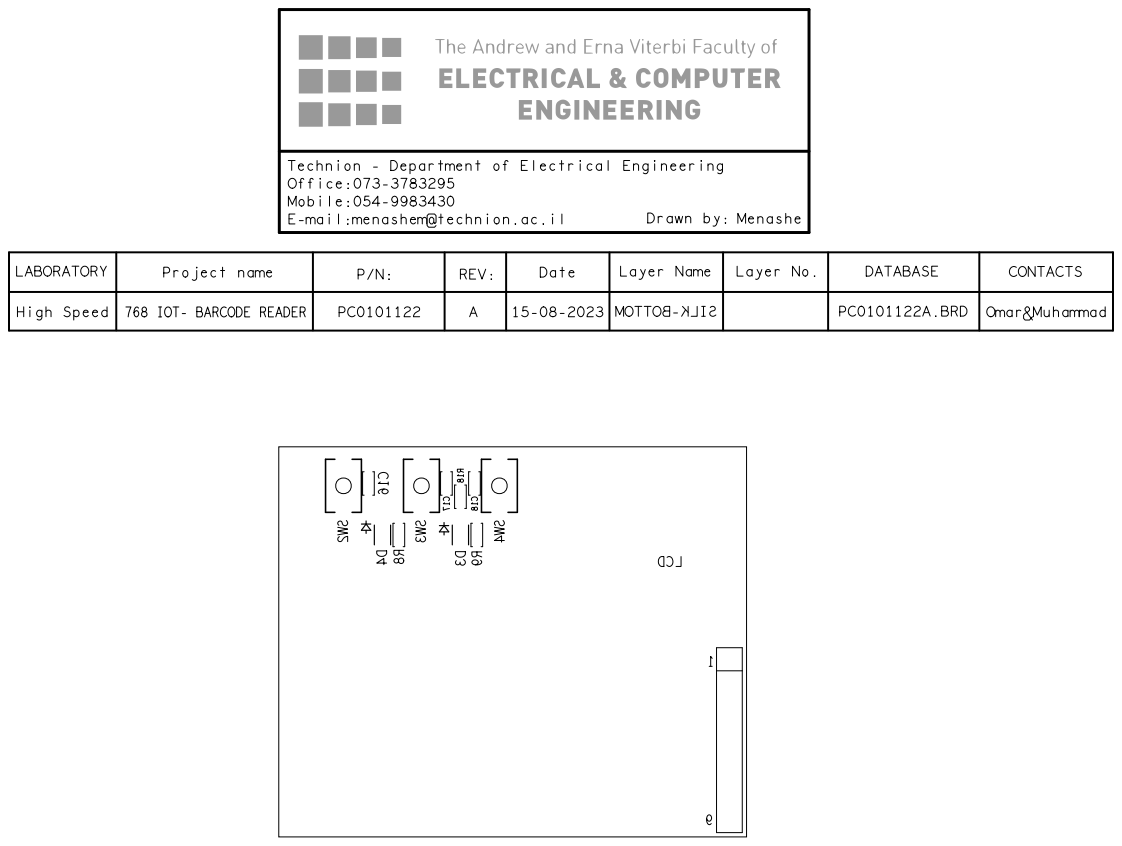
[picture p87: page 9]

Technion - Department of Electrical Engineering SW2 PC0101122
Office:073-3783295
Mobile:054-9983430
E-mail:menashem@technion.ac.il

LABORATORY | Project name | P/N: | Date | Layer Name | Layer No. | DATABASE | CONTACTS

High Speed | 768 IOT- BARCODE READER | | 15-08-2023 | | | PC0101122A.BRD | Omar&Muhammad

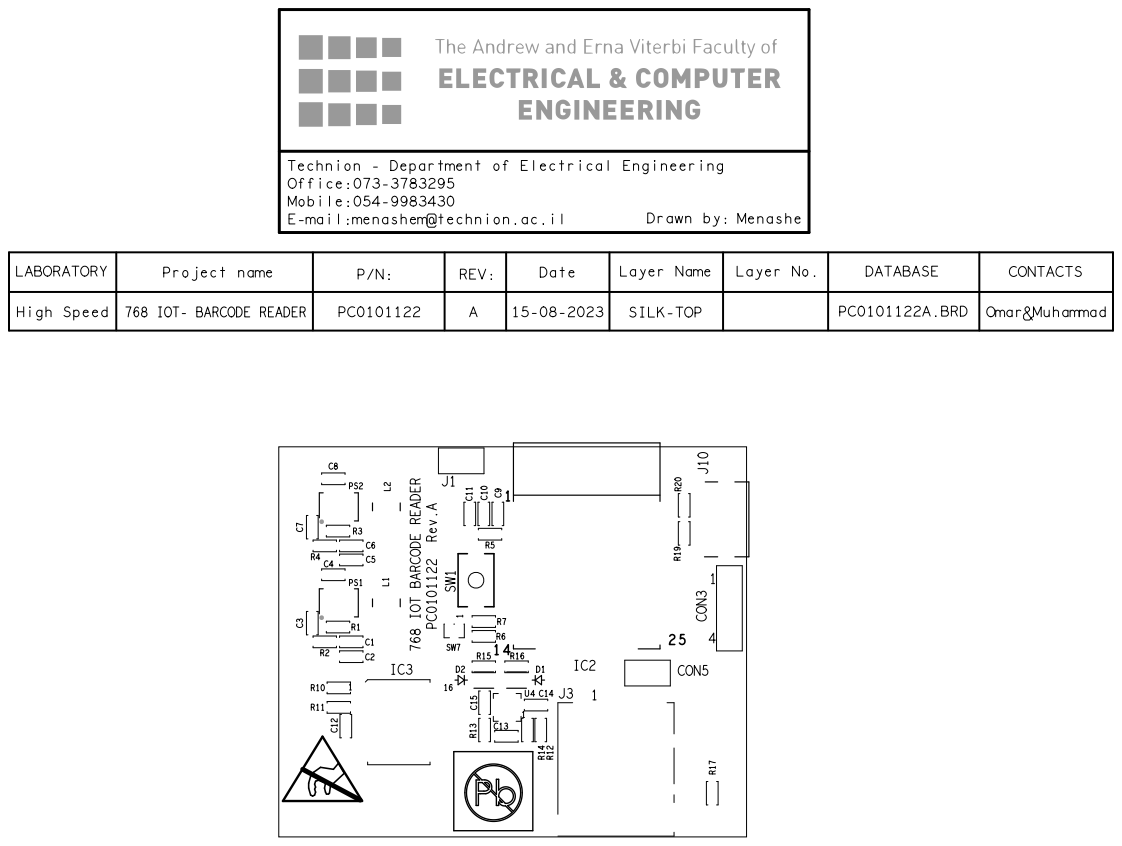
[picture p88: page 10]
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

LABORATORY | Project name | P/N: | | Layer Name | Layer No. | DATABASE | CONTACTS

High Speed | 768 IOT- BARCODE READER | | 15-08-2023 | SILK-TOP | | PC0101122A.BRD | Omar&Muhammad

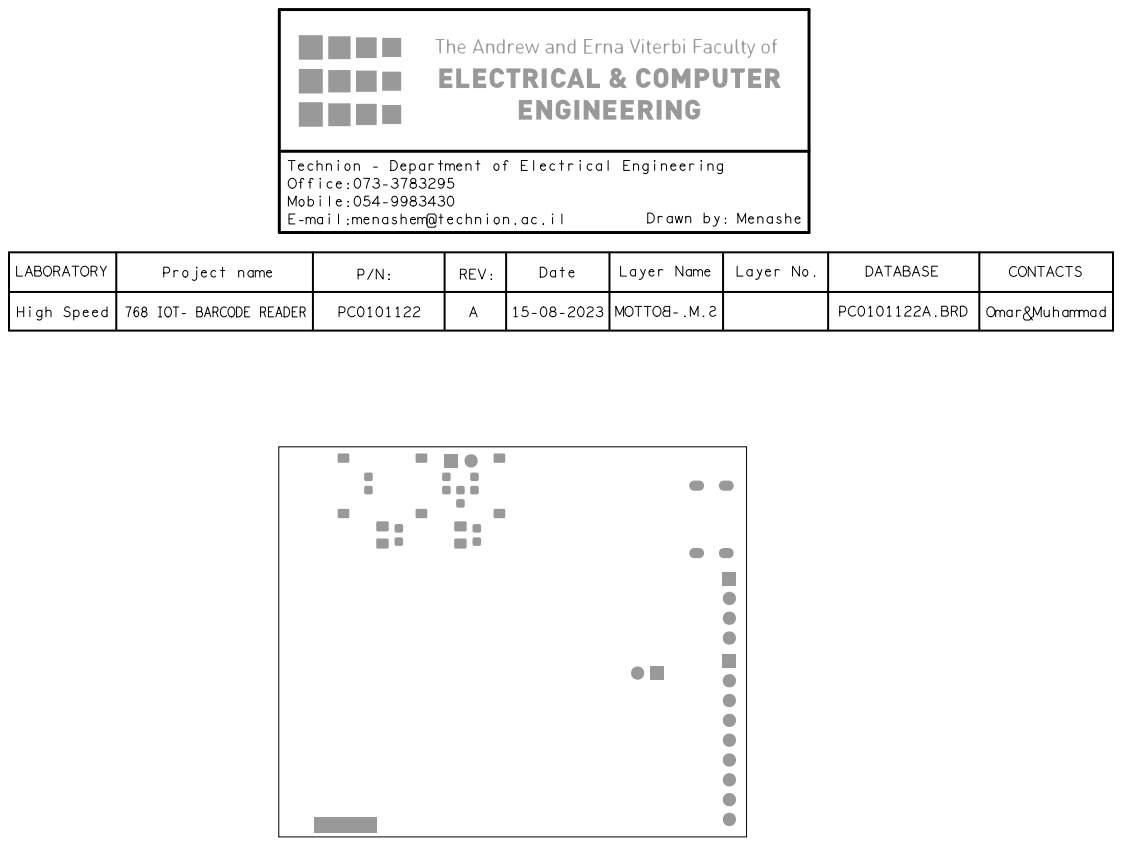
[picture p89: page 11]
Drawn by:; Menashe

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

LABORATORY | Project name | P/N: | REV: | Date | Layer Name | Layer No. | DATABASE | CONTACTS

High Speed | 768 IOT- BARCODE READER | PC0101122 | A | 15-08-2023 | | | PC0101122A.BRD | Omar&Muhammad

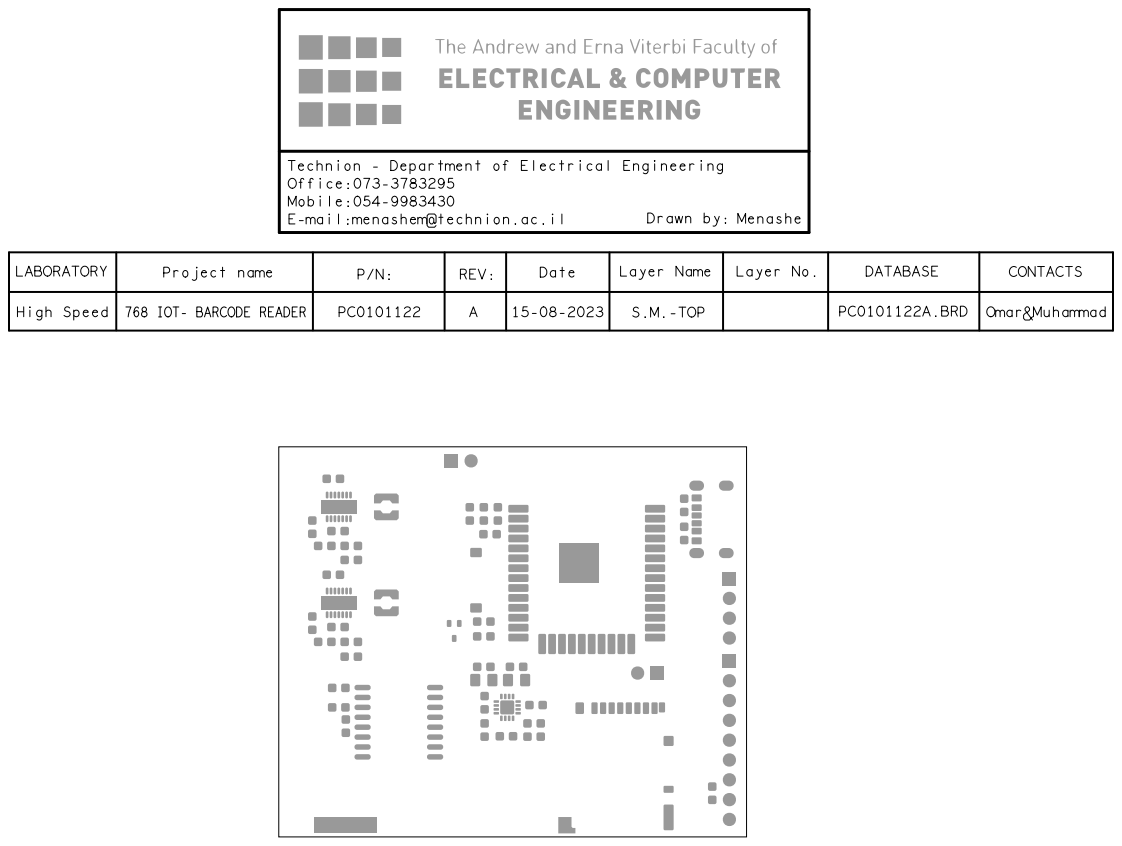
[picture p90: page 12]
Drawn by:; Menashe

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

LABORATORY | Project name | P/N: | REV: | Date | Layer Name | Layer No. | DATABASE | CONTACTS

High Speed | 768 IOT- BARCODE READER | PC0101122 | A | 15-08-2023 | S.M.-TOP | | PC0101122A.BRD | Omar&Muhammad

# REV

# DESCRIPTION

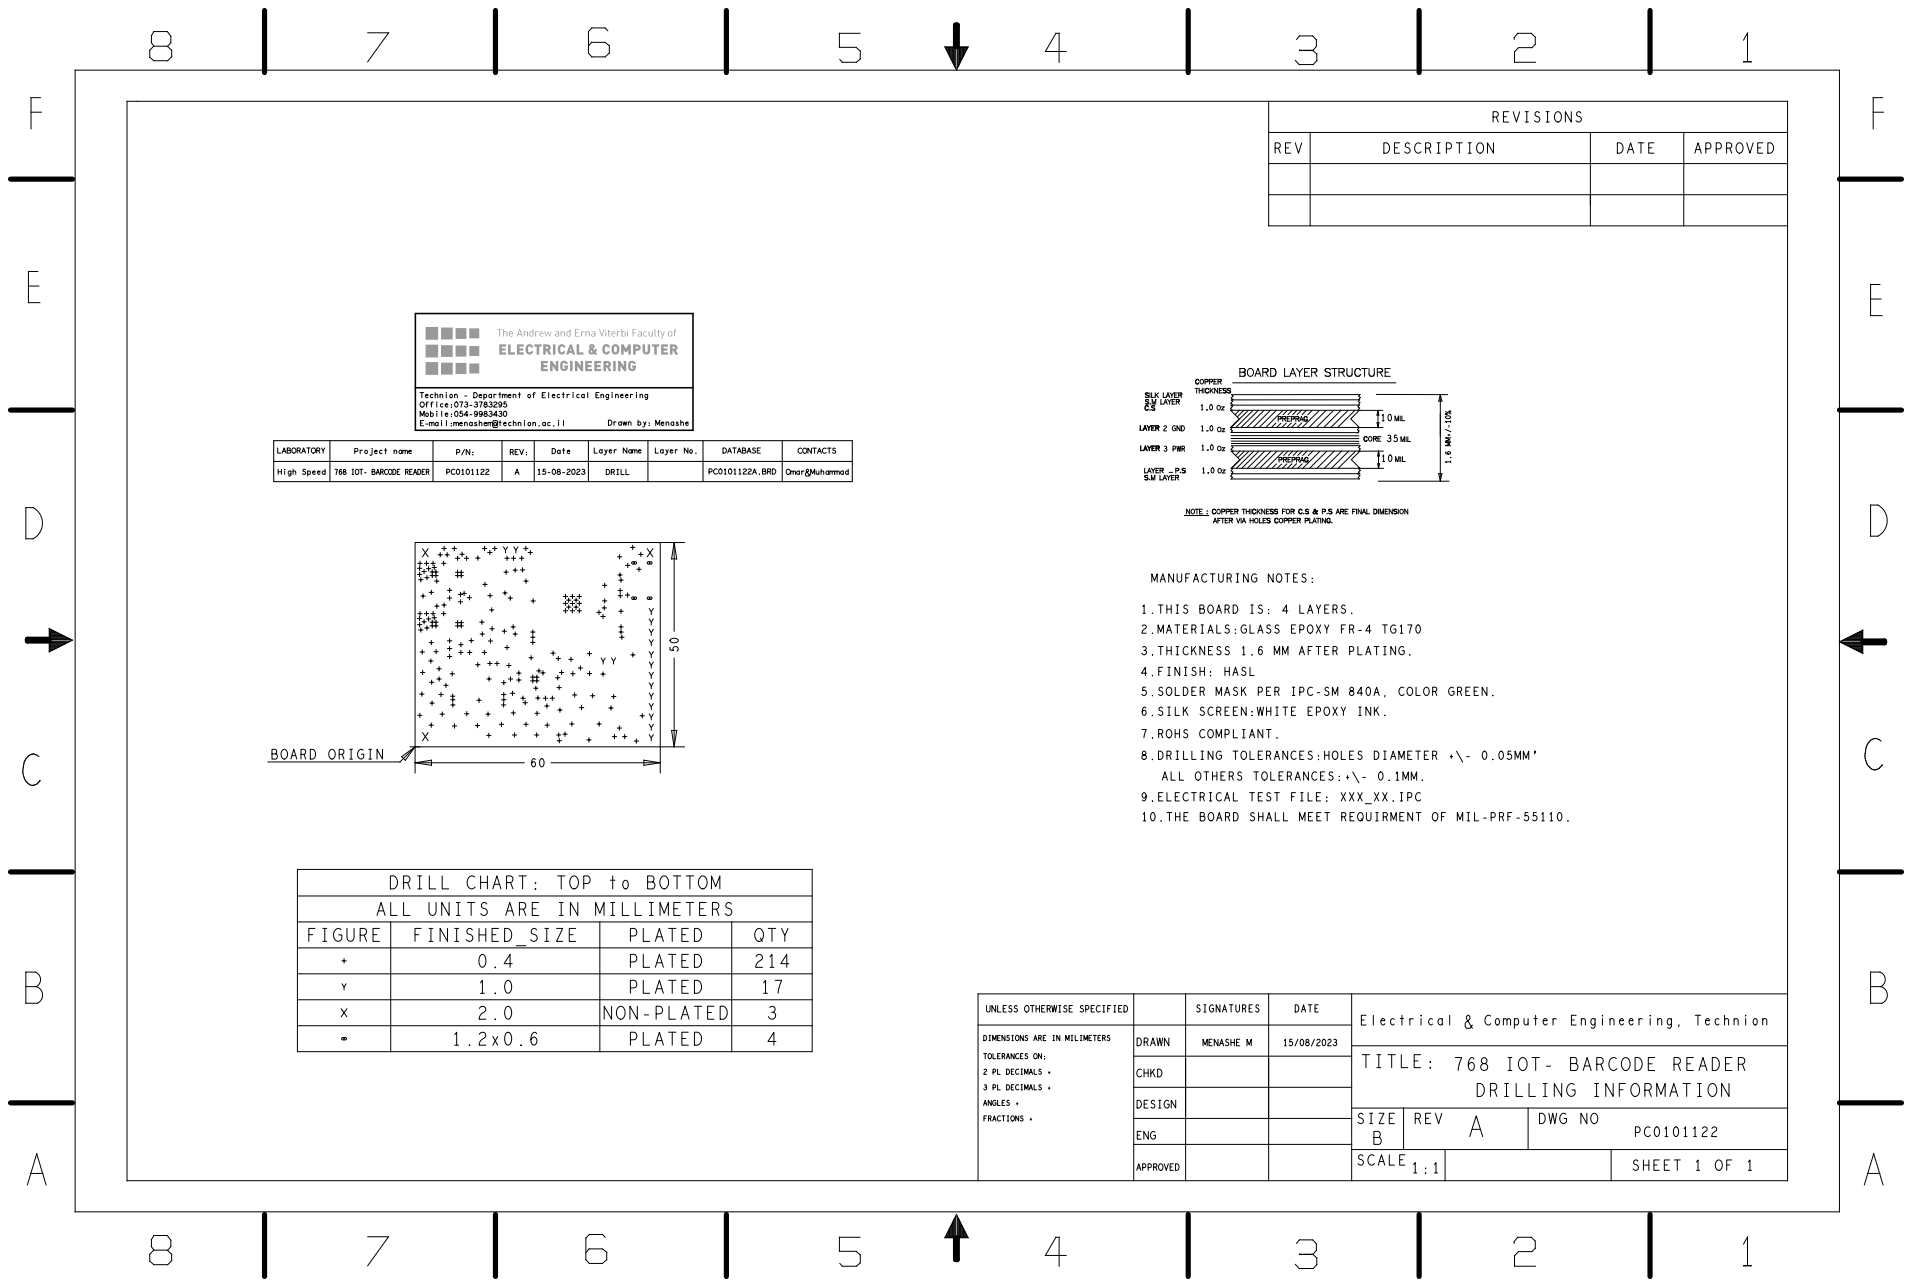
[picture p91: page 13]
BOARD ORIGIN; FIGURE; DRILL CHART:; TOP; to BOTTOM; NON-PLATED; Drawn by:; PLATED; Menashe 50; QTY; APPROVED; 10.THE; BOARD SHALL MEET; REQUIRMENT OF; MIL-PRF-55110.; 8.DRILLING TOLERANCES:HOLES DIAMETER; 7.ROHS; COMPLIANT.; 6.SILK; SCREEN:WHITE EPOXY; INK.; 5.SOLDER MASK PER IPC-SM 840A,; COLOR GREEN.; 4.FINISH:; HASL; 1.THIS; BOARD IS: 4 LAYERS.; MANUFACTURING NOTES:; ALL OTHERS; TOLERANCES:+\- 0.1MM.; 3 PWR; 2 GND; SIGNATURES; MENASHE; DATE; Electrical; & Computer Engineering, Technion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

LABORATORY | Project name | P/N: | REV: | Date | Layer Name | Layer No. | DATABASE | CONTACTS

High Speed | 768 IOT- BARCODE READER | PC0101122 | A | 15-08-2023 | DRILL | | PC0101122A.BRD | Omar&Muhammad

2.MATERIALS:GLASS EPOXY FR-4 TG170

3.THICKNESS 1.6 MM AFTER PLATING.

9.ELECTRICAL TEST FILE: XXX_XX.IPC

ALL UNITS ARE IN MILLIMETERS
FINISHED_SIZE

UNLESS OTHERWISE SPECIFIED

DIMENSIONS ARE IN MILIMETERS TOLERANCES ON: 2 PL DECIMALS + 3 PL DECIMALS + ANGLES + FRACTIONS + | DRAWN | 15/08/2023

768 IOT- BARCODE READER

CHKD

DESIGN

SIZE B | REV A | DWG NO PC0101122

ENG

SCALE 1:1
