muhammad0bi/Technion_044167_E.E._project_A_IOT-Barcode_cheker/Electrical Schematic/Corrected/Top.pdf

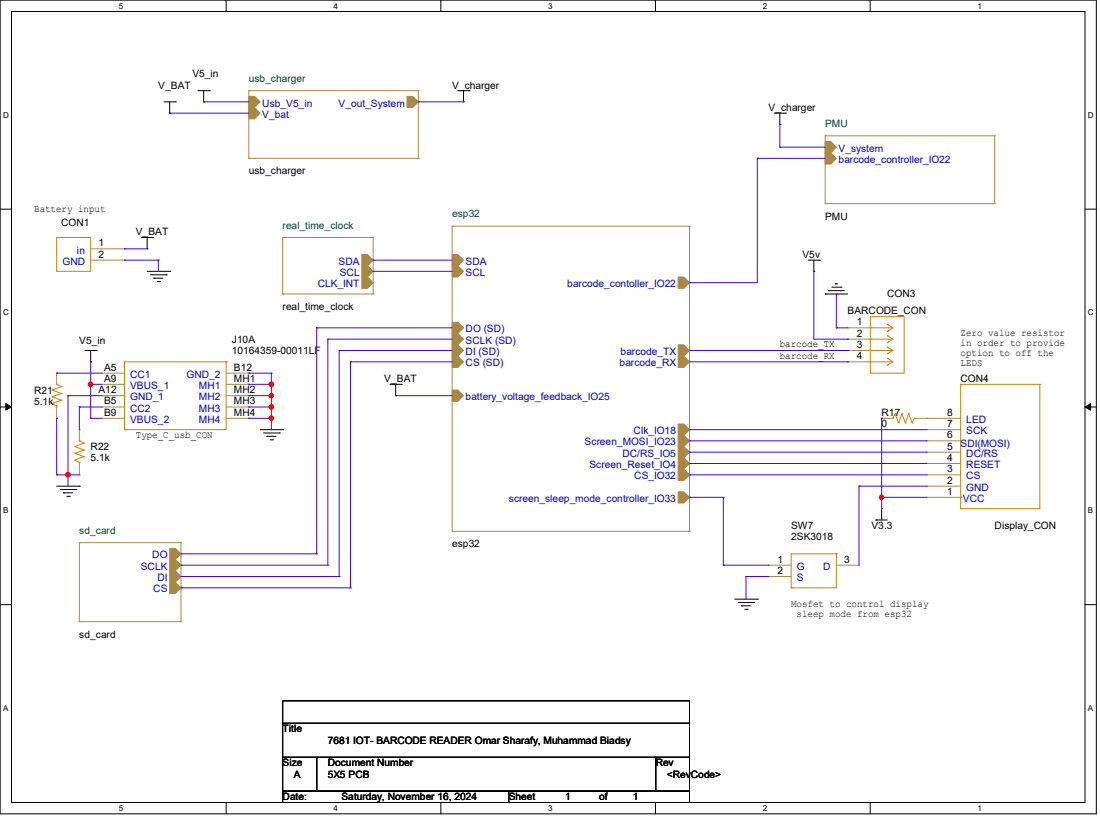
[picture p92: page 1]
barcode_RX; barcode_TX; Battery input; Type_C_usb_CON; V_BAT; V_charger; Title; Size; Document Number; Rev; Date:; Sheet; 5X5 PCB; <RevCode>; Saturday, November 16, 2024; real_time_clock; SCL; SDA; CLK_INT; sd_card; DO SCLK DI CS; Display_CON; 1 VCC; GND 2; RESET 4; SDI(MOSI); SCK 7; LED R17; PMU; barcode_controller_IO22; V_system; CC1 A5 VBUS_1 A9 GND_1 A12 CC2 B5; GND_2; CON1; in 1 GND 2; esp32; battery_voltage_feedback_IO25; SCLK (SD) DI (SD); screen_sleep_mode_controller_IO33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

Zero value resistor
in order to provide
option to off the
LEDS
CON4

VBUS_2 B9

Mosfet to control display
sleep mode from esp32

7681 IOT- BARCODE READER Omar Sharafy, Muhammad Biadsy
