muhammad0bi/Technion_044167_E.E._project_A_IOT-Barcode_cheker/Electrical Schematic/Corrected/USB_TYPE_C_CHARGER.pdf

## CHARGER THAT STOPS CHARGING AUTOMATICALLY WHEN THE BATRY IS FULL


THE CHARGE INPUT IS : USB TYPE-C INPUT
