muhammad0bi/Technion_044167_E.E._project_A_IOT-Barcode_cheker/Electrical Schematic/Corrected/ESP32.pdf

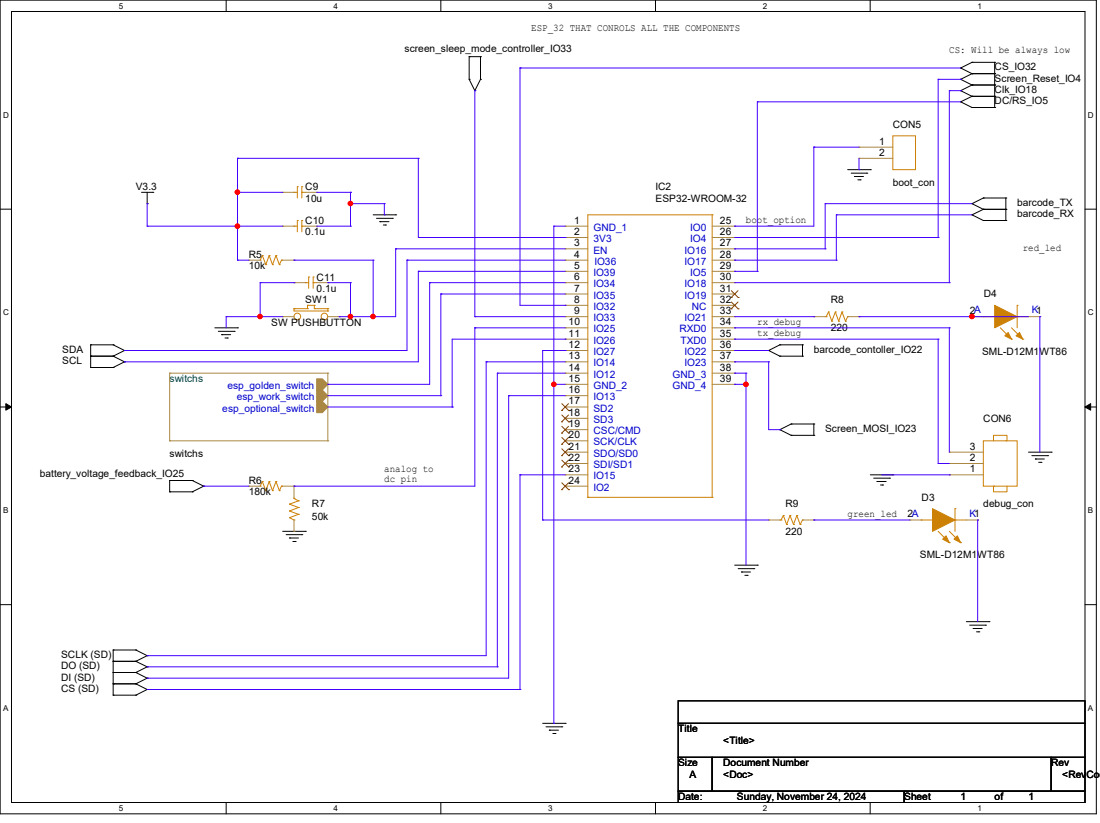
[picture p93: page 1]

ESP_32 THAT CONROLS ALL THE COMPONENTS

CS: Will be always low

EN 3

IO34 6
IO35 7 | R8
IO32 8

IO25 10 | rx_debug
IO26 11 | tx_debug
IO27 12
IO14 13
IO12 14

SD2 17 SD3 18 CSC/CMD 19 SCK/CLK 20 SDO/SD0 21 SDI/SD1 22 IO15 23
