muhammad0bi/Technion_044167_E.E._project_A_IOT-Barcode_cheker/(list of files, drawings)

Other design files:
Electrical Schematic/Corrected/7681_IOT_BARCODE_PC0101122A.DSN
Electrical Schematic/Corrected/7681_IOT_BARCODE_PC0101122A.opj
Electrical Schematic/Original/768_IOT_BAR-CODE_PC0101122A.DSN
Electrical Schematic/Original/768_IOT_BAR-CODE_PC0101122A.opj
Electrical Schematic/Original_re-wired/7681_IOT_BARCODE_PC0101122A.DSN
Electrical Schematic/Original_re-wired/7681_IOT_BARCODE_PC0101122A.opj
