muhammad0bi/Technion_044167_E.E._project_A_IOT-Barcode_cheker/(commit log)

2024-07-28 add folders + add new sections for the report
    [768_OMAR_BIADSY_MENASHE.opj, 768_OMAR_BIADSY_menashe.DSN]
2024-11-09 Add files via upload
    initial first working code
    work switch and optional is still not working
2024-11-16 Electrical schematic added
    [7681_IOT_BARCODE_PC0101122A.DSN, 7681_IOT_BARCODE_PC0101122A.opj, 768_IOT_BAR-CODE_PC0101122A.DSN, 768_IOT_BAR-CODE_PC0101122A.opj]
2024-11-16 project Arduino final code added
2024-11-23 Debug con added
    [7681_IOT_BARCODE_PC0101122A.DSN, 7681_IOT_BARCODE_PC0101122A.opj]
2024-12-09 Original_re-wired schematic added
    [7681_IOT_BARCODE_PC0101122A.DSN, 7681_IOT_BARCODE_PC0101122A.opj]
2024-12-09 appendix re-wired esp32 added + pdf report
